sivarconf/2026-/2.0/log.md

# 代码修改日志

## 2026-05-18

### 冷却期结束后重复识别同一张牌 Bug 修复

**问题**：`StabilityStateMachine` 的 COOLDOWN 分支中，冷却期结束后会清空 `confirmed_cards` 和 `confirmed_ranks`，导致同一张牌在冷却期结束后可以被再次确认。

**修复**：冷却期结束后只重置追踪状态（`vote_window`、`vote_counts`等），**保留** `confirmed_cards` 和 `confirmed_ranks`，使排除记录在整次运行中永久生效。

### 滑动窗口投票机制实现

**修改内容**：`StabilityStateMachine` 从连续帧确认改为滑动窗口投票：

1. **参数变更**：`CONSECUTIVE_THRESH=3` → `WINDOW_SIZE=5` + `VOTE_THRESH=3`
2. **数据结构**：用 `vote_window` 列表（最近5帧的 Top1 idx）+ `vote_counts` 字典（各牌出现次数）替代 `current_candidate_consec`
3. **投票逻辑**：每帧先将过滤后的 Top1 入队，窗口满时弹出旧帧；检查是否有牌出现次数达到3次即确认
4. **OSD 显示**：适配新数据结构，显示投票进度条和窗口内容、置信度总和

**修改文件**：`K230/main.py`

### 投票平票时以置信度优先

**修改内容**：`StabilityStateMachine` 新增 `vote_scores` 字典记录窗口内各牌的置信度总和。

**平票裁决逻辑**：
- 多张牌同时达到3票时，首先选**票数最多**的牌
- 若票数相同，则选**置信度总和最高**的牌
- 优先确保识别结果更可靠

**修改文件**：`K230/main.py`

---

## 2026-05-17

### v2.0 最终版发布

- 基于 1.3 封装为最终版 2.0
- 代码已解决所有已知问题，完工

---

## 2026-05-17

### 版本号统一升至 2.0 + 说明书全面同步

**版本变更：**
- 所有 STM32 .c/.h 文件：1.1 → 2.0
- K230/main.py：1.3 → 2.0
- 竞赛小车工程总说明书：v2.2 → v2.0

**说明书最终同步（v2.0 正式版）：**
1. §1.2 B-5 按键描述修正
2. §3.3 bsp_oled/user_main 功能描述更新（无调参页）
3. §4.7 OLED 页面系统：删除 PARAM_B/PARAM_F
4. §5.1 状态图：K2→K3
5. §5.4 按键表/参数表重写（稳定/竞赛模式）
6. §5.2.6 声光提示 K2→K3
7. §7.1/§7.2 流程图 K1 功能更新
8. §8 调参指南重写（编译期固定参数 + 四组参数表）
9. 附录B 版本记录全部更新

### OLED 第一行格式修正

**问题**：`"ti: B%-8s%u%u..."` 格式串产出 21 字符，128px 宽度（16 字符）装不下。

**修复**（`stm32/Core/Src/bsp_oled.c`）：
- 改为 `"ti:%c(%c) %u%u%u%u%u%u%u%u"` 精确 16 字符
- C=竞赛模式，S=稳定模式
- 格式：`ti:B(C) 00000000` 或 `ti:F(S) 00000000`

### 说明书 §6.3 同步至 v16（架构审查 → 文档修复）

**问题**：K230 算法已回退至 v16，但说明书 §6.3 仍描述 v34 完整设计（候选池加权积累、花色总和裁决、7张难检牌等），与代码严重脱节。

**修复**（`竞赛小车工程总说明书.md`）：
1. §1.2 F-1 完成度：算法v34 → 算法v16，保留JOKER优化
2. §3.1 目录树 main.py 描述：v34 → v16
3. §3.3 文件功能一览 main.py 行数/版本：~994/算法v34 → ~684/算法v16
4. §6.3 **整节重写**：从 v34 完整设计替换为 v16 连续帧确认，包含：
   - 回退说明 + 实际参数表（MIN_CONF=0.45, BLANK_GAP=0.30, WARMUP=10, CONSEC=3, COOLDOWN=20）
   - 四关过滤 + 连续帧确认 + S_A↔JOKER交换 + JOKER_B Boost + 单轮排除机制
   - 与 v34 差异对比（移除/保留清单 + 回退理由）
5. 附录B：K230/main.py 版本更新为 1.3（v16回退版，2026-05-17）

### 说明书 K2/K3 按键功能写反修正

**问题**：说明书 §5.4/§7.1/§7.2 中 K2=启动、K3=切题，但代码实际是 K2=切题、K3=启动（2026-05-15 已互换，log有记录）。

**修复**（`竞赛小车工程总说明书.md`）：
1. §5.4 按键处理逻辑表：K2/K3 行互换
2. §5.4 F题启动时序：K2→K3
3. §7.1 B题流程图：K3切题→K2切题，K2启动→K3启动
4. §7.2 F题流程图：同上

### 说明书 §5.4/§8 调参页残留清理

**问题**：代码已删除调参页，新增 K1 切换稳定/竞赛模式，但说明书 §5.4 按键表/§5.1 状态图/§8 调参指南仍描述旧的 OLED 调参行为。

**修复**（`竞赛小车工程总说明书.md`）：
1. §5.1 状态机图：K2→K3
2. §5.4 按键表：重写为 K1 切换模式 / K2 切题 / K3 启动 / K4 停车
3. §5.4 PID参数表：新增 B-S/B-C/F-S/F-C 四组参数
4. §8 调参指南：重写为编译期固定参数 + 四组参数表 + 修改指引

### CARD_COVER_THRESH 死代码修复

**需求**：删除小车的调参设置，添加稳定模式，用按键切换稳定模式/竞赛模式。

**修改内容**：

1. **`stm32/Core/Inc/bsp_oled.h`** — 清理页面枚举，删除 `OLED_PAGE_PARAM_B`、`OLED_PAGE_PARAM_F`、`OLED_PAGE_STABLE_MODE`，只保留 `OLED_PAGE_STANDBY`

2. **`stm32/Core/Src/bsp_oled.c`** — 删除 `Page_Param()` 函数，删除 `OLED_PAGE_PARAM_B/F` 的 switch case，`Page_Standby()` 第一行改为动态显示模式：`ti: B(S)` / `ti: B(C)` / `ti: F(S)` / `ti: F(C)` + 8位灰度值

3. **`stm32/Core/Src/app_line.c`** — 新增两套稳定模式参数：
   - B题稳定模式：base=1000, KP=8.5, KI=0.5, KD=4.5
   - F题稳定模式：base=630, KP=5.7, KI=0, KD=4
   - 新增 `s_stable_mode` 标志、`App_Line_IsStableMode()`、`App_Line_ToggleStableMode()`
   - `App_Line_Init()` 和 `App_Line_Task()` 根据稳定模式选择对应参数组

4. **`stm32/Core/Inc/app_line.h`** — 新增 `App_Line_IsStableMode()`、`App_Line_ToggleStableMode()` 函数声明

5. **`stm32/Core/Src/user_main.c`** — 删除全部调参逻辑（K1进调参页/K2选参数/K3+1/K4-1），K1改为待机页/完成页/错误页切换稳定/竞赛模式

**按键行为（修改后）**：
| 按键 | 待机/完成/错误页 | 运行时 |
|---|---|---|
| K1 | 切换稳定模式(S)/竞赛模式(C) | 无效 |
| K2 | 切换题目B/F | 无效 |
| K3 | 启动运行 | 无效 |
| K4 | 无效 | 手动停车 |

**OLED第一行格式**：`ti: B(S) 11111111`（7字符 + 空格 + 8位灰度 = 16字符）

---

## 2026-05-17

### 说明书 §6.3 同步至 v16（架构审查 → 文档修复）

**问题**：K230 算法已回退至 v16，但说明书 §6.3 仍描述 v34 完整设计（候选池加权积累、花色总和裁决、7张难检牌等），与代码严重脱节。

**修复**（`竞赛小车工程总说明书.md`）：
1. §1.2 F-1 完成度：算法v34 → 算法v16，保留JOKER优化
2. §3.1 目录树 main.py 描述：v34 → v16
3. §3.3 文件功能一览 main.py 行数/版本：~994/算法v34 → ~684/算法v16
4. §6.3 **整节重写**：从 v34 完整设计替换为 v16 连续帧确认，包含：
   - 回退说明 + 实际参数表（MIN_CONF=0.45, BLANK_GAP=0.30, WARMUP=10, CONSEC=3, COOLDOWN=20）
   - 四关过滤 + 连续帧确认 + S_A↔JOKER交换 + JOKER_B Boost + 单轮排除机制
   - 与 v34 差异对比（移除/保留清单 + 回退理由）
5. 附录B：K230/main.py 版本更新为 1.3（v16回退版，2026-05-17）

### 说明书 K2/K3 按键功能写反修正

**问题**：说明书 §5.4/§7.1/§7.2 中 K2=启动、K3=切题，但代码实际是 K2=切题、K3=启动（2026-05-15 已互换，log有记录）。

**修复**（`竞赛小车工程总说明书.md`）：
1. §5.4 按键处理逻辑表：K2/K3 行互换
2. §5.4 F题启动时序：K2→K3
3. §7.1 B题流程图：K3切题→K2切题，K2启动→K3启动
4. §7.2 F题流程图：同上

### CARD_COVER_THRESH 死代码修复

**问题**：`app_line.c` 第 154 行 `CARD_COVER_THRESH = LOST_THRESH_SHORT`（均为 30），导致判断链第二个 `else if (s_lost_cnt < CARD_COVER_THRESH)` 永远无法进入，扑克牌遮线专用逻辑（150ms~300ms 圆弧保持）是死代码。小车在 150ms 后直接进入中等丢线降速模式，而非圆弧保持，在圆形赛道上造成偏轨。

**修复**：
1. `stm32/Core/Src/app_line.c` — `CARD_COVER_THRESH` 从 30 改为 60（300ms）
2. `竞赛小车工程总说明书.md` §5.2.4 丢线保护策略表格更新：明确 150ms~300ms 为圆弧保持，300ms~500ms 为中等丢线降速

**修复后判断链**：
- `< 30` (150ms) → SHORT，保持上一 error 直行
- `< 60` (300ms) → CARD_COVER，保持遮线前角度沿圆弧行进（生效！）
- `< 100` (500ms) → MED，降速找线
- `> 600ms` → ERROR 停车

**修改文件**：`stm32/Core/Src/app_line.c`、`竞赛小车工程总说明书.md`

---

## 2026-05-17

### K230 算法回退至1.0版（v16），保留小王优化

**问题**：1.3版本的v34复杂算法（候选池加权积累、7张难检牌专项优化、花色总和分析等）成功率反而不如1.0版本（v16滑动窗口）。

**决策**：将识别算法回退到1.0版本的v16框架，同时保留从v28/v29/v30移植的小王相关优化。

**回退内容**：
1. **状态机**：v34的候选池加权积累 → **v16滑动窗口连续帧确认**（5帧窗口/3帧确认）
2. **参数**：移除花色总和分析、7张难检牌专项优化、TOP2/3权重投票
3. **参数值**：MIN_CONFIDENCE 0.18→0.45，BLANK_GAP 0.10→0.30，WARMUP 5→30，COOLDOWN 15→20

**保留内容**：
1. **S_A ↔ JOKER 混淆修正**（v28）：Top1=S_A 且分差<0.25时交换两者softmax分值
2. **JOKER_B Boost 机制**（v29/v30）：JOKER_B分值≥0.10时×1.3放大，但Boost后与Top1差距<0.25才生效
3. **UI中文分色显示**（来自1.2版）：黑桃/梅花黑色，红桃/方块红色

**修改文件**：`K230/main.py`

---

## 2026-05-17

### B题第二圈停车后声光无法自动停止

**问题**：B题跑完第二圈后，蜂鸣器和 LED 持续响/亮，无法自动关闭。

**根因**：`s_alert_off_done` 标志在第一圈声光提示 1 秒后被置 1，但 `App_Line_Init()` 在再次运行时未重置该标志。`App_Line_CheckAlertOff()` 的条件是 `s_alert_done && !s_alert_off_done`，由于 `s_alert_off_done` 已是 1，条件恒为假，导致第二圈停车时重新打开的蜂鸣器和 LED 永远无法被关闭。

**修复**：
1. `app_line.c` - 第二圈/一圈完成触发声光时，主动重置 `s_alert_off_done = 0`（双重保障）
2. `user_main.c` - K4 手动停车时，立即关闭蜂鸣器和 LED

**修改文件**：`stm32/Core/Src/app_line.c`、`stm32/Core/Src/user_main.c`

---

## 2026-05-17

### 从 1.2 创建 1.3 存档

- 从 1.2 完整复制所有源码和配置文件
- 清理缓存：.pio、MDK-ARM/build

---

## 2026-05-17

### 说明书 v2.2 修正（§7.1/§7.2 流程图与代码对齐）

**修改文件**：`竞赛小车工程总说明书.md`

**修正内容：**

1. **文件头版本号**：v2.1 → v2.2，更新日期 2026-05-15 → 2026-05-17
2. **§5.2.4 丢线保护表格**：`150ms~150ms` 注释错误 → `150ms~500ms`（两行描述互换）
3. **§7.1 B题流程图**：补充说明 K230全程不参与；明确第一圈声光1秒后自动关闭；第二圈无声光直接停车
4. **§7.2 F题流程图**：明确仅跑一圈；K230在第一圈完成后收到STOP并锁定识别结果；停车时蜂鸣器短响80ms
5. **§7.1/§7.2 关键行为说明**：新增「关键行为说明」小节，解释两题的核心区别
6. **附录B代码版本记录**：STM32版本更新为1.2（BUG修复版）；说明书版本更新为v2.2
7. **文档维护说明**：补充「修改后同步更新」四条规范

---

## 2026-05-15（下午）

### 两题停车时均增加声光提示

**修改文件**：`app_line.c`、`app_line.h`、`user_main.c`

**需求**：B题和F题在最终停车时都应发出声光提示（蜂鸣器+LED）。

**修改内容**：

1. **`app_line.c`** — 停车时统一触发声光：
   - B题第二圈停车时：蜂鸣器响 + LED亮，1秒后自动关闭
   - F题一圈停车时：蜂鸣器响 + LED亮，1秒后自动关闭（与B题停车行为一致）
   - B题第一圈声光提示逻辑保持不变

2. **`app_line.c`** — 新增 `App_Line_CheckAlertOff()` 函数：
   - 检查声光提示是否已达到1秒
   - 达到后自动关闭蜂鸣器和LED
   - 避免在 `App_Line_Task()` 之外（状态已切换为FINISHED）无法执行关闭逻辑

3. **`app_line.h`** — 新增 `App_Line_CheckAlertOff()` 声明

4. **`user_main.c`** — 主循环中调用 `App_Line_CheckAlertOff()`：
   - 每次主循环检查声光是否需要关闭
   - 适用于B题第一圈提示、B题第二圈停车、F题停车三种场景

**最终声光触发时机**：
|| 题目 | 触发时机 | 蜂鸣器 | LED |
||---|---|---|-----|
|| B题 | 第一圈完成 | 响1秒 | 亮1秒 |
|| B题 | 第二圈（最终）停车 | 响1秒 | 亮1秒 |
|| F题 | 一圈（最终）停车 | 响1秒 | 亮1秒 |

### 代码审查修复（2026-05-15 晚）

**修复内容：**

1. **app_line.c** — 修正注释：描述改为与 PDF 题目一致（基础题=走两圈+声光，发挥题=一圈+K230识别），修复"150ms~150ms"注释错误
2. **user_config.h** — 新增 `WHEEL_DIAMETER_CM = 100` 常量，供 OLED 距离计算使用
3. **bsp_oled.c** — 待机页距离计算公式改为 `enc_total / ONE_LAP_COUNT * pi * WHEEL_DIAMETER_CM`
4. **K230/main.py** — JOKER_B Boost 条件修正：检查 Boost 后差距而非 Boost 前
5. **bsp_uart_k230.h** — 协议注释修正：移除旧 `$START`/`$STOP` 字符串协议，改为单字节 `0x01`/`0x02`
6. **app_control.c** — 删除无用的 `(void)` 强转语句
7. **bsp_gray.c** — 版本号更新为 1.1 / 2026-05-15

### 代码审查 - 发现多个严重 Bug

**审查范围**：STM32 全部源码 + K230/main.py + 所有头文件 + 竞赛说明书

**发现严重 Bug（需立即修复）：**

#### 🔴 Bug 1：B题/F题逻辑完全写反了

**文件**：`stm32/Core/Src/app_line.c` 第 305-324 行

**问题**：注释写 "F题" 但代码是 `QUESTION_B`，注释写 "B题" 但代码是 `QUESTION_F`
- `QUESTION_B` 时声光提示（应为 F 题行为）
- `QUESTION_F` 时发 STOP（应为 F 题行为，但 F 题应该停车）

**实际后果**：
| 题目 | 预期 | 实际 |
|---|---|---|
| B题 | 一圈声光→再跑一圈→停车 | 直接停车（没有声光） |
| F题 | 一圈停车+K230停止识别 | 声光提示（无停止识别） |

**修复**：将第 305 行和第 313 行中的 `QUESTION_B` ↔ `QUESTION_F` 互换

#### 🔴 Bug 2：F题串口START发送逻辑位置错误

**文件**：`stm32/Core/Src/user_main.c` 第 117-120 行

**问题**：K3 按下启动时发送 `$START`，但根据 log.md 最新记录（待机页 K2=启动，K3=切换题目），F题按 K2 启动时不会发送 `$START`

**修复**：将 `BSP_UART_K230_SendStart()` 移到 K2 的启动分支中

#### 🔴 Bug 3：OLED待机页距离计算公式错误

**文件**：`stm32/Core/Src/bsp_oled.c` 第 115 行

**问题**：直接用 `314.0f`（π×100）计算，未考虑 enc_total 是累计值
- 正确：`dist = enc_total / ONE_LAP_COUNT * π * D`
- 当前：`dist = enc_total / ONE_LAP_COUNT * 314`（两圈时显示翻倍）

**修复**：改为 `enc_total / ONE_LAP_COUNT * 3.14159f * WHEEL_DIAMETER_CM`

#### 🔴 Bug 4：编码器达到上限后继续累加

**文件**：`stm32/Core/Src/app_line.c` 第 298-302 行

**问题**：ENC_TOTAL_MAX 截断后下一帧仍继续累加 delta，导致编码器值在上限附近持续波动

**修复**：达到上限后不再累加，或设置标志位

#### 🔴 Bug 5：K230 JOKER_B Boost 条件注释与代码逻辑不符

**文件**：`K230/main.py` 第 636-638 行

**问题**：注释说"差距过大时跳过"，但检查的是 boost 前的差距。应改为检查 boost 后的差距

**修复**：改为 `if boosted_jb > 0 and top1_val - boosted_jb < JOKER_B_MAX_GAP:`

#### 🟡 Bug 6：bsp_uart_k230.h 注释协议与代码不符

**问题**：头文件注释写的是 `$START\n`/`$STOP\n`，实际代码发送的是 `0x01`/`0x02` 单字节

#### 🟡 Bug 7：app_control.c 无用的 (void) 强转

**文件**：`app32/Core/Src/app_control.c` 第 40-43 行

**问题**：`App_Control_SetLineParams()` 函数有一串无意义的 `(void)` 语句

#### 🟡 Bug 8：bsp_gray.c 版本号未更新

**文件**：`stm32/Core/Src/bsp_gray.c` 第 12 行

**问题**：版本 1.0，日期 2026-05-13，其他文件都已更新到 1.1 / 2026-05-15

#### 🟡 Bug 9：app_line.c 注释数字写错

**文件**：`stm32/Core/Src/app_line.c` 第 264 行

**问题**：注释写"150ms~150ms"，应为"150ms~500ms"

---

### 待机页按键2/3功能互换

**修改文件**：`stm32/Core/Src/user_main.c`

**互换内容**：
- K2：待机页由"启动"改为"切换题目（B/F）"
- K3：待机页由"切换题目"改为"启动"

**调整理由**：操作习惯更顺手。

---

### 竞赛小车工程总说明书 v2.1 — 题目细节补充 + 串口功能明确

**更新内容：**

1. **第1章增加详细题目描述**：赛道形状、扑克牌放置方式（背面朝上/正面朝上）、检测方式
2. **第1章增加关键设计考量**：圆形赛道、摄像头识别难点
3. **发挥部分完成度更新**：移除「识别结果回传OLED」，改为「K230 LCD中文显示」（已实现）
4. **第6章串口协议明确**：STM32 ↔ K230 串口仅负责 START/STOP 控制，不承载识别结果数据
5. **待完成功能精简**：移除K230结果回传相关条目，保留ONE_LAP_COUNT实测标定（高优先级）

**待完成功能（精简后）：**
- 高优先级：ONE_LAP_COUNT 实测标定
- 中优先级：K230与STM32联调、B题第二圈、F题LCD界面优化

### K230 扑克牌识别算法 v1.1 — 最终稳定版

**本次整理**：删除 v8-v34 详细迭代记录，保留最终版本核心说明。

**最终参数配置**：

| 参数 | 值 | 说明 |
|---|-----|---|
| MIN_CONFIDENCE | 0.18 | 最低置信度门槛 |
| BLANK_GAP | 0.10 | Top1 与 BLANK 的最小差距 |
| TOP_GAP_THRESH | 0.08 | Top1 与 Top2 最小差距 |
| TOP1_NOISE_THRESH | 0.50 | Top1 弱识别阈值 |
| VOTE_THRESH | 3 | 确认所需票数 |
| MIN_VOTE_FRAMES | 2 | 确认所需最少帧数 |
| COOLDOWN_FRAMES | 10 | 确认后冷却帧数 |
| JOKER_GAP_THRESH | 0.25 | S_A 与 JOKER 交换阈值 |
| TOP23_MIN_CONF | 0.18 | Top2/3 最低置信度 |
| WARMUP_FRAMES | 5 | 开机预热帧数 |

**最终参数配置（续）**：

| 参数 | 值 | 说明 |
|---|-----|---|
| TOP2_WEIGHT | 0.5 | Top2 投票权重 |
| TOP3_WEIGHT | 0.3 | Top3 投票权重 |
| JOKER_B_DETECT_MIN | 0.10 | JOKER_B Boost 最低分值 |
| JOKER_B_BOOST_MULT | 1.3 | JOKER_B Boost 系数 |
| JOKER_B_MAX_GAP | 0.25 | JOKER_B Boost 最大差距 |

**算法核心特性**：

1. **S_A ↔ JOKER 混淆修正**（v28/v33）：
   - 当 Top1=S_A 且 S_A 与 JOKER 分差 < 0.25 时交换两者 softmax 值
   - 解决小王/大王被误识别为黑桃A 的问题

2. **JOKER_B Boost 机制**（v29/v30）：
   - JOKER_B 分值 >= 0.10 时乘以 1.3 放大
   - Boost 后与 Top1 差距 >= 0.25 时跳过 Boost（防止误触发）

3. **花色总和分析**（v33）：
   - 移除花色补偿，改为计算每种花色的 softmax 置信度总和
   - 同颜色不同花色冲突时（H vs D，S vs C），用花色总和对进行裁决

4. **7张难检牌专项优化**（v27/v31）：
   - C_10、C_6、C_8、C_9、C_K、D_Q、JOKER_B
   - Top1 保护机制：困难牌 Top1 时允许 Top2 更接近
   - 难检牌确认门槛更低（vote_score >= 0.25）

5. **候选池加权积累**（v25/v26/v27）：
   - 冷却期内 Top1 → +1.0 票，Top2 → +0.5 票，Top3 → +0.3 票
   - 每帧检查候选池，达到阈值立即确认

6. **同 rank 过滤**：
   - confirmed_cards 永久排除（整次运行）
   - cooldown_ranks 临时排除（仅冷却期内）

7. **TRACKING 分支降级投票**：
   - Top1 被确认/冷却时自动降级到 Top2/3

**算法版本演进简史**：

| 版本 | 核心改进 |
|---|---|
| v8 | 稳定性确认 + 冷却期状态机 |
| v13 | confirmed_ranks 集合防一牌多结果 |
| v16 | 永久排除 confirmed_cards |
| v20 | 修复冷却期 rank 检查 bug |
| v23 | 每张牌独立 vote_count |
| v25 | COOLDOWN 每帧检查候选池 |
| v27 | 7张难检牌专项优化 |
| v28 | S_A ↔ JOKER 混淆修正 |
| v29 | JOKER_B Boost 机制 |
| v31 | D_Q boost + Top1 保护 |
| v33 | 花色总和分析替代花色补偿 |
| v34 | 参数微调（漏牌问题优化） |

### K230 代码整理 v1.3 — UI 中文分色 + FPS 恢复

**UI 增强**：
1. **FPS 恢复**：左上角显示 FPS
2. **中文 + 红黑分色**：`label_to_display()` 函数将标签转为中文显示
   - 黑桃/梅花：黑色 (0,0,0)
   - 红桃/方块：红色 (255,0,0)
   - 小王：黑色，大王：红色
3. **结果展示**：46号字体，超过8张时分两列（第9张起从右边开始排）
4. **识别中已确认列表**：28号字体，按红黑色显示

**修改文件**：`K230/main.py`

## 2026-05-15（下午）

### 代码整理 v1.1 — 删除冗余注释 + 统一版本号

**问题**：多个源码文件存在大量重复的文件头注释（同一个文件有 2-3 个重复的 `@file` 块），版本号均为 1.0，需要清理。

**`stm32/Core/Src/app_line.c`**：
- 去除重复文件头注释
- 版本更新为 1.1，日期更新为 2026-05-15
- 注释描述精简，保留核心功能说明

**`stm32/Core/Src/bsp_oled.c`**：
- 版本更新为 1.1，日期更新为 2026-05-15
- 注释描述修正

**`stm32/Core/Src/app_control.c`**：
- 版本更新为 1.1，日期更新为 2026-05-15

**`stm32/Core/Src/bsp_uart_k230.c`**：
- 去除重复文件头注释（原有 3 个重复块）
- 版本更新为 1.1，日期更新为 2026-05-15

**`stm32/Core/Src/app_state.c`**：
- 去除重复文件头注释（原有 3 个重复块）
- 版本更新为 1.1，日期更新为 2026-05-15

**`stm32/Core/Src/bsp_motor.c`**：
- 去除重复文件头注释（原有 2 个重复块）
- 版本更新为 1.1，日期更新为 2026-05-15

**`stm32/Core/Src/bsp_encoder.c`**：
- 去除重复文件头注释（原有 2 个重复块）
- 版本更新为 1.1，日期更新为 2026-05-15

**`stm32/Core/Src/bsp_beep.c`**：
- 去除重复文件头注释（原有 2 个重复块）
- 版本更新为 1.1，日期更新为 2026-05-15

**`stm32/Core/Src/bsp_led.c`**：
- 去除重复文件头注释（原有 3 个重复块）
- 版本更新为 1.1，日期更新为 2026-05-15

**`stm32/Core/Src/bsp_gray.c`**：
- 去除重复文件头注释
- 版本更新为 1.1，日期更新为 2026-05-15

**`stm32/Core/Src/bsp_delay.c`**：
- 去除重复文件头注释（原有 2 个重复块）
- 版本更新为 1.1，日期更新为 2026-05-15

**`stm32/Core/Src/bsp_key.c`**：
- 去除重复文件头注释（原有 2 个重复块）
- 版本更新为 1.1，日期更新为 2026-05-15

**`K230/main.py`**：
- 去除内部版本标注混乱
- 版本更新为 1.1，日期更新为 2026-05-15
- 文件头注释精简，保留核心功能说明

## 2026-05-15（凌晨）

### K230 识别算法 v34 — 微调参数减少漏牌

**问题回顾（v33 测试反馈）**：
- 基本差不多了，有部分漏牌和错误
- 换个角度或位置基本都能测准
- 花色裁决 Top1/2 分差调到 0.2 效果很不错

**v34 参数微调（基于用户反馈）**：

| 参数 | v33 | v34 | 说明 |
|---|-----|-----|---|
| 花色裁决 gap | 0.10 | **0.20** | 效果很好，用户确认 |
| MIN_CONFIDENCE | 0.20 | **0.18** | 接收更多弱识别帧 |
| BLANK_GAP | 0.12 | **0.10** | 更多弱帧能通过 |
| TOP23_MIN_CONF | 0.20 | **0.18** | 与 MIN_CONFIDENCE 同步 |
| 普通牌确认门槛 | >=0.30, gap>=0.20 | **>=0.28, gap>=0.15** | 更易确认减少漏牌 |

### K230 识别算法 v33 — 彻底移除花色补偿，改为花色总和裁决

**问题回顾（v32 测试反馈）**：
- 数量准确，颜色准确
- 同颜色不同花色分不清（如红桃 vs 方块、黑桃 vs 梅花）
- 花色补偿会影响原本就正常的识别
- 小王又变成黑桃A

**v33 核心重构**：
1. **完全移除花色补偿**：删除 `_compute_suit_boosted_scores()`
2. **新增花色总和分析**：`_compute_suit_sums()` 计算每种花色的 softmax 总置信度和
3. **新增花色裁决**：`_resolve_suit_conflict()` 当 Top1/2 分差 < 0.20 且同颜色不同花色时，比较两花色的总置信度和
4. **JOKER_GAP_THRESH: 0.15→0.25**：更容易把 S_A 换下去

### K230 识别算法 v31 — 针对性优化7张难检牌

**问题回顾（v30 日志分析）**：
- 测试牌组：梅花10、梅花6、梅花8、方块Q、梅花9、小王、梅花K
- 确认：C_10、S_A、C_8、C_7、S_J、C_K、S_Q、JOKER_B、S_9（9张）
- **误确认：S_6（真牌是梅花6）** — Top1 始终是 S_6，C_6 从未出现
- **误确认：S_J（真牌是方块Q）** — Top1 始终是 H_J/D_Q，S_J 确认
- **丢失：D_Q（方块Q）** — D_Q 出现在 Top2/3，但从未达到 Top1
- **丢失：C_6（梅花6）** — 被 S_6 压制，从未出现

**v31 根因分析**：
1. **D_Q 丢失**：方块Q 置信度系统性偏低，SUIT_BOOST_SUITS 只有 C 和 JOKER_B，没有 D
2. **C_6 被 S_6 压制**：困难牌 Top1 与 Top2 分差极小时被降权，S_6=0.387, C_6=0.312 → gap 仅 0.075，vote_score 降权后 < MIN_CONF=0.20，无法投票
3. **S_J 被误确认**：D_Q=0.232, H_J=0.233，D_Q 应该是 Top1 但 H_J 以微弱优势获胜
4. **S_A 冷却期内误加入候选池**：S_A 确认后，冷却期内 Top1=S_A 时被加入候选池，干扰下一张牌确认

**v31 核心修复**：
1. **D_Q boost**：将 D 加入 SUIT_BOOST_SUITS `{"C", "D", "JOKER_B"}`
2. **JOKER_GAP_THRESH 降低**：0.20 → 0.15，更敏感识别 S_A↔JOKER 混淆
3. **困难牌 Top1 保护**：困难牌 Top1 时允许 Top2 不超过 Top1×1.2
4. **S_A 冷却期保护**：冷却期内 Top1 是 S_A 时不加入候选池

### K230 识别算法 v30 — JOKER_B Boost 防误触发机制

**v30 核心修复：Boost 防误触发机制**：
- `JOKER_B_MAX_GAP = 0.25`：Boost 后 JOKER_B 与 Top1 差距必须 < 0.25 才生效
- Boost 系数从 1.5 降至 1.3（温和放大，减少把普通牌误推上 Top1 的风险）

### K230 识别算法 v29 — JOKER_B Boost 机制

**v29 根因分析**：
- JOKER_B 自身 softmax 分值过低（<0.10），即使出现在帧中也过不了识别阈值
- v28 的 S_A 交换逻辑只解决"S_A 误识别为 JOKER"的问题

**v29 核心修复：JOKER_B Boost 机制**：
- JOKER_B softmax 分值 >= 0.10 时，直接乘以 1.5 倍放大
- Boost 在 S_A 交换之后执行，确保 JOKER_B 能从交换中获益

### K230 识别算法 v28 — S_A↔JOKER混淆修正 + 花色补偿优化

**v28 根因分析（小王误识别为S_A）**：
- 模型对 JOKER_B 存在系统性误识别：softmax 中 S_A 得分较高，JOKER_B 得分紧随其后
- 典型场景：S_A=0.55, JOKER_B=0.42，分差仅 0.13

**v28 核心修复：S_A ↔ JOKER_* 混淆修正**：
- 当 Top1=S_A 且 S_A-JOKER_* 分差 < JOKER_GAP_THRESH=0.20 时，交换两者 softmax 分值

### K230 识别算法 v27 — 7张难检牌专项优化

**v27 根因分析**：
- 7张难检牌中，**5张是梅花花色**，模型对梅花存在系统性置信度偏低
- Top1 与 Top2/3 的分差极小（gap < 0.08），TOP1_NOISE 大量触发
- 极低置信度帧（0.20~0.30）被硬性丢弃

**v27 三大核心优化**：
1. **花色级置信度补偿**：对梅花/小王，将同花色所有牌的 softmax 分值累加到目标牌
2. **候选池加权计数**：Top1→+1.0票，Top2→+0.5票，Top3→+0.3票
3. **TRACKING 分支动态阈值**：难检牌 vote_score >= 0.20 即投票

### K230 识别算法 v26 — 修复"一张牌检测到多张"问题

**v25 Bug 根因分析**：
- COOLDOWN 分支只过滤 `idx ∈ confirmed_cards`，不检查 rank
- 冷却期内同一物理牌的不同花色全部进入候选池 → 某花色达到2票 → 被误确认为新牌

**v26 核心修复**：
1. COOLDOWN 分支增加 rank ∈ cooldown_ranks 过滤
2. TRACKING 分支增加 rank ∈ cooldown_ranks 过滤 + 降级投票

### K230 识别算法 v25 — 难检牌专项优化

**v25 根因分析与核心修复**：
1. TRACKING 分支 Top1 被过滤时直接丢弃 → 改为降级投票
2. COOLDOWN 分支候选池积累不足 → 确保每帧至少一个候选
3. COOLDOWN 每帧检查候选池：达到阈值立即确认

### K230 识别算法 v23 — 每张牌独立 vote_count

**v23 Bug 详解**：
- 共享 vote_window 导致不同花色互抢
- D_5 和 H_3 各 1 票互不相让，H_3 永远无法确认

**v23 核心修复**：
- 每张牌有独立的 `vote_counts[idx]` 计数器
- 每帧只有 Top1 计入对应牌的计数器

### K230 识别算法 v22 — 候选池机制

**v22 Bug 详解**：
- 冷却期内 cls_idx=-1 的帧不加入 vote_window，导致冷却期结束后窗口为空

**v22 核心修复：引入候选池机制**：
- 冷却期内所有有效帧加入 candidate_pool
- 冷却期结束分析候选池，达到阈值则立即确认

## 2026-05-15（凌晨）

### K230 识别算法 v20 — 修复 COOLDOWN 分支 elif 缺少 rank 检查

**v19 致命 bug 详解**：
- COOLDOWN 分支 elif 只检查 `cls_idx in confirmed_cards`，没检查 `rank in cooldown_ranks`
- 导致 H_4 冷却期内 H_5 被误加入窗口，H_5 被误确认为假牌

**v20 核心修复**：
- COOLDOWN 分支 elif 增加 rank 检查
- 冷却期内 Top1 是已确认牌时，只有当 rank 不在 cooldown_ranks 中才替换

### K230 识别算法 v19 — 修复确认后窗口未清空

**v18 Bug**：
- 确认一张牌后 vote_window 未清空，已确认牌继续在窗口中占位

**v19 核心修复**：
- 确认后立即清空 vote_window
- 冷却期内也检查 cooldown_ranks

## 2026-05-14（深夜）

### K230 识别算法 v18 — 修复投票计数Bug（核心Bug导致8张牌0确认）

**v17 Bug**：
- `_add_to_window()` 中有去重逻辑，同一张牌第二次出现时被跳过
- `_get_best_in_window()` 统计的是不同牌的种类数，而不是每张牌的出现次数

**v18 核心修复**：
- 移除去重逻辑，同一张牌可以多次加入窗口
- 预热期缩短：30帧→15帧
- 冷却期缩短：20帧→15帧

### K230 识别算法 v17 — 滑动窗口投票 + 宽松冷却

**v16 丢牌分析**：
- H_3 被检测到但因部分帧置信度 0.45-0.57 低于 0.60 阈值

**v17 核心修复**：
- MIN_CONFIDENCE 从 0.60 → 0.45
- 滑动窗口投票：5帧窗口，3帧同牌确认
- 冷却期只排具体牌，不排同 rank

## 2026-05-14（晚）

### K230 识别日志功能

- 每次运行在 K230 `/data/` 目录写 `recognition_log.txt`
- 记录每帧的 cls_idx、Top-N、置信度、状态机状态、投票信息
- 关键事件（START/STOP/CONFIRMED）突出记录

## 2026-05-13（晚）

### 代码整理 + 注释规范化 + 版本1.0封装

**文件头注释补全**：为所有C源文件添加标准文件头注释（@file、@brief、功能概述、版本、日期）。

**`app_line.h`**：Kp/Ki/Kd 类型从 `float` 改为 `int16_t`（配合参数扩大10倍存储）

**`app_line.c`**：
- PID 参数扩大10倍存储（B_KP=120/B_KD=50/F_KP=60/F_KD=40）
- 去除重复的 PID 参数赋值代码块

**`bsp_oled.c`**：`Page_Param()` 改用整数运算替代 `%f` 浮点格式化

### 圆形赛道循迹优化（误差平滑 + 积分项）

- **F题启用积分项**：`F_KI` 从 0 改为 3（消除稳态误差）
- **B题 BASE_PWM** 从 1250 调整为 1300

### PID 参数扩大10倍存储（支持±0.1微调）

- PID 参数内部扩大10倍存储（int16_t），OLED 显示时除以 10.0
- K3/K4 每次 ±1，对应实际 PID 值变化 ±0.1

## 2026-05-13（下午）

### OLED 上电初始化延时修复

- 新 OLED 屏幕内部有更长的上电稳定时间
- `OLED_Init()` 开头增加 100ms 延时

### K230 识别算法 v16 — 解决"一张牌检测出多张牌"问题

**v15 根因**：冷却期结束后重置 `confirmed_cards` 和 `confirmed_ranks`，导致同一张牌被重新确认

**v16 核心修复**：
- `confirmed_cards` 和 `confirmed_ranks` 在整次运行中永久生效
- 冷却期结束后不清空，只清空 `vote_window`

### K230 识别算法 v15 — 滑动窗口投票

- 7帧滑动窗口，3帧同牌确认
- 允许模型在窗口中跳1-2帧，减少丢牌

### K230 识别算法 v14 — 彻底重写状态机（连续帧确认）

- 连续5帧确认替代窗口统计
- 打断即重置，从根本上堵住积分游戏漏洞

### K230 识别算法 v13 — 修复一牌多结果 + 防无牌误识别增强

- 新增 `confirmed_ranks` 集合，同 rank 所有牌同时过滤
- BLANK_GAP 提高：0.20 → 0.25

### K230 识别算法 v12 — 确认后立即排除已确认牌

- 新增 `confirmed_cards` 集合（永久排除）
- 每帧先过滤已确认牌，Top1 被确认则自动替换为 Top2

### K230 识别算法 v10 — 解决 H_7/D_7 互抢丢牌 + 花色置信度裁决

- 去掉 Top-N 辅助计数，只计最终 Top1
- 新增 `_resolve_frame()` 花色置信度裁决

### K230 识别算法 v9 — 参数优化（针对前两张牌丢牌率高）

- 预热期：50帧→30帧，窗口：20帧→15帧
- 确认阈值：8次→6次，冷却期：20帧→15帧

### K230 识别算法全面重写 v8 — 稳定性确认 + 冷却期状态机

- `StabilityStateMachine` 类替代 `SlidingWindowManager`
- 状态流转：IDLE → CONFIRMING → COOLDOWN
- 冷却期机制彻底解决"一张牌读出多种"问题

## 2026-05-12（下午）

### OLED待机页显示行驶距离和用时

- 待机页第二行：行驶距离（cm）
- 待机页第三行：行驶用时（精确到0.01秒）
- 快照变量记录停车时刻的编码器值

### K230 数据收集脚本更新

- 6种类别（C_7, D_3, D_K, D_Q, JOKER_B, JOKER_R）
- 每种 200 张（1 批次），共 1200 张

### K230 识别器 v6/v7 — BLANK 防误识别 + 开机预热

- BLANK 分差门槛：Top1 必须比 BLANK 高至少 0.15
- 开机预热：前15帧识别结果不入滑动窗口

### K230 LCD 屏幕驱动修复

- 使用 `Display.show_image(img, x=0, y=0, mode=1)` 驱动 LCD 主帧缓冲
- 建议升级到 PreRelease 固件解决黑屏/闪屏问题

## 2026-05-12（上午）

### K230 数据收集脚本重写（扑克牌识别训练数据）

- 54种扑克牌类别（A~K × 4花色 + 大小王）
- 类别命名：`S_A` ~ `S_K`, `H_A` ~ `H_K`, `C_A` ~ `C_K`, `D_A` ~ `D_K`, `JOKER_B`, `JOKER_R`
- 分辨率 640×480，按键控制采集

### K230 LCD 屏幕不显示问题修复

## 2026-05-11（晚）

### F题串口通信 + K230扑克牌识别展示

- STM32 → K230：`$START\n` / `$STOP\n`
- K230 串口协议改为纯字节：0x01(START)/0x02(STOP)
- 白屏展示：白色背景，中文花色名称逐行打印

### 题目逻辑修正 + 代码清理

- B题：一圈后声光提示，再跑完一圈停车（共两圈）
- F题：一圈后直接停车

## 2026-05-11

### OLED页面简化：删除调试页，自动跳转待机页

### 题目枚举重构：B1→B（基础题），B2→F（发挥题）

### K230 main.py 全面迁移至 PipeLine 框架

- 适配 CanMV K230 v1.6
- 通道0显示，通道2 AI推理

## 2026-05-10

### 代码全面检查与修复

- `gpio.c`：修正 PB4/PB5 引脚注释
- `09_1数据收集.py`：修复按键去抖逻辑错误
- `app_line.c`：为 `s_enc_total` 添加上限保护

### B2题声光提示修正 + LED亮灭逻辑修正

- 声光提示1秒后自动关闭
- LED 亮灭逻辑修正

### 基础题B1/B2双题支持及一圈/两圈计数

- 新增 `QuestionType_t` 枚举
- B1：一圈停车，B2：两圈后声光提示再跑完两圈停车

### 巡线一圈自动停车功能

- `ONE_LAP_COUNT` 宏定义一圈目标编码器值
- 达到目标后自动停车 + 切换 FINISHED 状态

### 巡线方向修正（左右PWM分配反了）

- 交换左右轮 PWM 公式

## 2026-05-09

### 第五阶段：开环低速循迹

- 8路灰度权重设计：`-40,-20,-10,-5,+5,+10,+20,+40`
- PD控制：`pwm_out = Kp*error + Kd*(error - last_error)`
- 丢线保护：150ms内保持上一周期，500ms内降速，600ms以上停车

## 2026-05-08

- 检查并整理 STM32 工程结构
- 修正右轮电机接线顺序
- 新增编码器测试功能
- 扩展串口调试命令支持

## 2026-05-09

### 灰度传感器驱动开发

- 纯软件模拟 I2C，PA5=SCL, PA4=SDA
- I2C 地址 0x4E（AD1=1, AD0=0）
- 支持 ping、数字量、模拟量、错误信息、版本号读取

### 最终接线对应

| 总线 | SCL | SDA | 用途 |
|---|---|---|---|
| 灰度传感器（软件模拟 I2C） | PA5 | PA4 | 灰度 8 路传感器 |
| OLED（硬件 I2C1） | PB8 | PB9 | OLED 显示屏 |

### 2026-05-20 | main_new2.py VOTING 窗口判断 bug 修复

**问题**：`VOTING` 状态下窗口结束条件用 `voting_frames_collected >= WINDOW_SIZE`，但该计数器只在低置信度帧（cls_idx < 0 或无 valid candidates）时不递增，导致低置信度帧出现时窗口无限拉长。

**修复**：将窗口结束条件改为 `round_total_frames >= WINDOW_SIZE`（每帧必递增），并修正 `_tick_finalize` 调用以避免 `cls_idx < 0` 时引用未定义变量 `valid`。

### 2026-05-20 | main_new2.py DISCARDING 帧数超时修复

**问题**：`DISCARDING` 状态下 `cls_idx < 0` 或无 valid candidates 时直接 return，`round_total_frames` 未递增，帧配额被浪费，导致无限等待。

**修复**：入口统一递增 `round_total_frames`，设置总超时上限 `DISCARD_FRAMES + WINDOW_SIZE = 9` 帧，超时后强制进入 VOTING（重置投票状态后继续，不丢弃本轮）。

### 2026-05-21 | app_line.c F题参数统一

**修改**：挑战题（F题）不再区分稳定模式和高速模式，统一使用一套参数：PWM=600，KP=6.0，KI=0，KD=4.0。基础题（B题）两种速度及其他参数保持不变。

### 2026-05-21 | main_new2.py v22 回顾一致性检查（S_10 vs C_8 覆写）

**目的**：解决 S_10 和 C_8 容易互相误识别的问题。当投票确认 S_10 后，对本轮投票历史做回顾检查，三条件全满足则覆写为 C_8。

**条件**：
- 条件 A：S_10 当 top1 的比例 < 85%（有其他类抢过 #1）
- 条件 B：C_8 分数 > 0.05 出现在 Top3 中出现过 >= 3 帧（C_8 不是偶然露脸）
- 条件 C：S_10 > 0.7 的高置信帧 < 3 帧（S_10 缺乏持续高分）

**修改点**：
- `StabilityStateMachine.__init__`：增加 `C_8_idx` 属性
- 新增 `_retrospective_s10_vs_c8_check(confirmed_idx, history)` 方法
- `_tick_confirm` / `_tick_finalize`：在确认时调用回顾检查，追加 `should_override` 返回值
- `tick` 方法：所有返回语句增加第 8 元素 `should_override=False`
- `vote_history`：每帧记录增加 `"top3"` 字段用于条件 B 检测
- 主循环：确认后检查 `should_override`，为 true 时将结果覆写为 C_8
- 版本升至 v22 / 2.2
