sivarconf/2026-/3.0/log.md

# 代码修改日志

## 2026-05-21

### 版本升至 3.0 — 全面整理代码 + 清理死代码 + 修正注释

**所有文件版本统一升至 3.0，日期统一为 2026-05-21。**

#### 死代码清理

**`stm32/Core/Src/app_line.c`** — 删除以下未被调用的函数和变量：
- `s_tune_param` 静态变量（运行时调参已废弃）
- `App_Line_GetTuneParam()`
- `App_Line_NextTuneParam()`
- `App_Line_AdjustQuestionTuneParam()` — 替换为空桩（仍有外部声明引用）
- `App_Line_PrintDebug()`
- `App_Line_SetParams()`
- `LINE_BASE_PWM_STEP`、`LINE_PID_STEP` 宏

**`stm32/Core/Src/app_control.c`** — 删除 `App_Control_SetLineParams()` 死函数

**`stm32/Core/Inc/app_control.h`** — 删除 `App_Control_SetLineParams()` 声明

**`stm32/Core/Inc/app_line.h`** — 同步删除未使用函数声明：
- 删除 `LineTuneParam_t` 枚举
- 删除 `App_Line_SetParams()`、`App_Line_GetTuneParam()`、`App_Line_NextTuneParam()`、`App_Line_AdjustQuestionTuneParam()`、`App_Line_PrintDebug()` 声明

#### 注释修正

**`stm32/Core/Inc/app_state.h`** — 修正 `QuestionType_t` 枚举注释：
- `QUESTION_B`: "基础题：循迹一圈后声光提示，再跑完一圈停车"（原来写反了）
- `QUESTION_F`: "发挥题：循迹一圈后停车，K230识别扑克牌"（原来写反了）

**`stm32/Core/Src/app_line.c`** — 修正 F题注释：
- `F_BASE_PWM = 700` 注释 → `F_BASE_PWM = 600`
- F题稳定模式参数修正：base=630, KP=57(KP=5.7)

**`stm32/Core/Src/bsp_oled.c`** — 文件头注释修正：
- 删除"调参B页/调参F页"描述（调参页已删除）

**`stm32/Core/Src/bsp_gray.c`** — 文件头注释全面重写：
- 删除"16路灰度"、"SPI1"等错误描述
- 更新为"8路灰度传感器"、"软件模拟I2C"

#### 版本更新

|| 文件 | 旧版本 | 新版本 |
|---|---|---|---|
| 所有 STM32 .c/.h 文件 | 2.0 | 3.0 |
| `K230/main.py` | 2.2 | 3.0 |

---

## 2026-05-18

### 冷却期结束后重复识别同一张牌 Bug 修复

**问题**：`StabilityStateMachine` 的 COOLDOWN 分支中，冷却期结束后会清空 `confirmed_cards` 和 `confirmed_ranks`，导致同一张牌在冷却期结束后可以被再次确认。

**修复**：冷却期结束后只重置追踪状态（`vote_window`、`vote_counts`等），**保留** `confirmed_cards` 和 `confirmed_ranks`，使排除记录在整次运行中永久生效。

### 滑动窗口投票机制实现

**修改内容**：`StabilityStateMachine` 从连续帧确认改为滑动窗口投票：

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

**修改文件**：`K230/main.py`

### 投票平票时以置信度优先

**修改内容**：`StabilityStateMachine` 新增 `vote_scores` 字典记录窗口内各牌的置信度总和。

**平票裁决逻辑**：
- 多张牌同时达到3票时，首先选**票数最多**的牌
- 若票数相同，则选**置信度总和最高**的牌
- 优先确保识别结果更可靠

**修改文件**：`K230/main.py`

---

## 2026-05-17

### v2.0 最终版发布

- 基于 1.3 封装为最终版 2.0
- 代码已解决所有已知问题，完工

---

## 2026-05-17

### 版本号统一升至 2.0 + 说明书全面同步

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

### OLED 第一行格式修正

**问题**：`"ti: B%-8s%u%u..."` 格式串产出 21 字符，128px 宽度（16 字符）装不下。

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

### 说明书 §6.3 同步至 v16（架构审查 → 文档修复）

**问题**：K230 算法已回退至 v16，但说明书 §6.3 仍描述 v34 完整设计（候选池加权积累、花色总和裁决、7张难检牌等），与代码严重脱节。

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

### 说明书 K2/K3 按键功能写反修正

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

### 说明书 §5.4/§8 调参页残留清理

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

### CARD_COVER_THRESH 死代码修复

**需求**：删除小车的调参设置，添加稳定模式，用按键切换稳定模式/竞赛模式。

**修改内容**：

1. **`stm32/Core/Inc/bsp_oled.h`** — 清理页面枚举，删除 `OLED_PAGE_PARAM_B`、`OLED_PAGE_PARAM_F`、`OLED_PAGE_STABLE_MODE`，只保留 `OLED_PAGE_STANDBY`

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

4. **`stm32/Core/Inc/app_line.h`** — 新增 `App_Line_IsStableMode()`、`App_Line_ToggleStableMode()` 函数声明

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

**OLED第一行格式**：`ti: B(S) 11111111`（7字符 + 空格 + 8位灰度 = 16字符）

---

## 2026-05-17

### 说明书 §6.3 同步至 v16（架构审查 → 文档修复）

**问题**：K230 算法已回退至 v16，但说明书 §6.3 仍描述 v34 完整设计（候选池加权积累、花色总和裁决、7张难检牌等），与代码严重脱节。

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

### 说明书 K2/K3 按键功能写反修正

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

### CARD_COVER_THRESH 死代码修复

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

**修改文件**：`stm32/Core/Src/app_line.c`、`竞赛小车工程总说明书.md`

---

## 2026-05-17

### K230 算法回退至1.0版（v16），保留小王优化

**问题**：1.3版本的v34复杂算法（候选池加权积累、7张难检牌专项优化、花色总和分析等）成功率反而不如1.0版本（v16滑动窗口）。

**决策**：将识别算法回退到1.0版本的v16框架，同时保留从v28/v29/v30移植的小王相关优化。

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

**修改文件**：`K230/main.py`

---

## 2026-05-17

### B题第二圈停车后声光无法自动停止

**问题**：B题跑完第二圈后，蜂鸣器和 LED 持续响/亮，无法自动关闭。

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

**修改文件**：`stm32/Core/Src/app_line.c`、`stm32/Core/Src/user_main.c`

---

## 2026-05-17

### 从 1.2 创建 1.3 存档

- 从 1.2 完整复制所有源码和配置文件
- 清理缓存：.pio、MDK-ARM/build

---

## 2026-05-17

### 说明书 v2.2 修正（§7.1/§7.2 流程图与代码对齐）

**修改文件**：`竞赛小车工程总说明书.md`

**修正内容：**

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

---

## 2026-05-15（下午）

### 两题停车时均增加声光提示

**修改文件**：`app_line.c`、`app_line.h`、`user_main.c`

**需求**：B题和F题在最终停车时都应发出声光提示（蜂鸣器+LED）。

**修改内容**：

1. **`app_line.c`** — 停车时统一触发声光：
   - B题第二圈停车时：蜂鸣器响 + LED亮，1秒后自动关闭
   - F题一圈停车时：蜂鸣器响 + LED亮，1秒后自动关闭（与B题停车行为一致）
   - B题第一圈声光提示逻辑保持不变

2. **`app_line.c`** — 新增 `App_Line_CheckAlertOff()` 函数：
   - 检查声光提示是否已达到1秒
   - 达到后自动关闭蜂鸣器和LED
   - 避免在 `App_Line_Task()` 之外（状态已切换为FINISHED）无法执行关闭逻辑

3. **`app_line.h`** — 新增 `App_Line_CheckAlertOff()` 声明

4. **`user_main.c`** — 主循环中调用 `App_Line_CheckAlertOff()`：
   - 每次主循环检查声光是否需要关闭
   - 适用于B题第一圈提示、B题第二圈停车、F题停车三种场景

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

### 代码审查修复（2026-05-15 晚）

**修复内容：**

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

### 代码审查 - 发现多个严重 Bug

**审查范围**：STM32 全部源码 + K230/main.py + 所有头文件 + 竞赛说明书

**发现严重 Bug（需立即修复）：**

#### 🔴 Bug 1：B题/F题逻辑完全写反了

**文件**：`stm32/Core/Src/app_line.c` 第 305-324 行

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

**实际后果**：
| 题目 | 预期 | 实际 |
|---|---|---|
| B题 | 一圈声光→再跑一圈→停车 | 直接停车（没有声光） |
| F题 | 一圈停车+K230停止识别 | 声光提示（无停止识别） |

**修复**：将第 305 行和第 313 行中的 `QUESTION_B` ↔ `QUESTION_F` 互换

#### 🔴 Bug 2：F题串口START发送逻辑位置错误

**文件**：`stm32/Core/Src/user_main.c` 第 117-120 行

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

**修复**：将 `BSP_UART_K230_SendStart()` 移到 K2 的启动分支中

#### 🔴 Bug 3：OLED待机页距离计算公式错误

**文件**：`stm32/Core/Src/bsp_oled.c` 第 115 行

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

**修复**：改为 `enc_total / ONE_LAP_COUNT * 3.14159f * WHEEL_DIAMETER_CM`

#### 🔴 Bug 4：编码器达到上限后继续累加

**文件**：`stm32/Core/Src/app_line.c` 第 298-302 行

**问题**：ENC_TOTAL_MAX 截断后下一帧仍继续累加 delta，导致编码器值在上限附近持续波动

**修复**：达到上限后不再累加，或设置标志位

#### 🔴 Bug 5：K230 JOKER_B Boost 条件注释与代码逻辑不符

**文件**：`K230/main.py` 第 636-638 行

**问题**：注释说"差距过大时跳过"，但检查的是 boost 前的差距。应改为检查 boost 后的差距

**修复**：改为 `if boosted_jb > 0 and top1_val - boosted_jb < JOKER_B_MAX_GAP:`

#### 🟡 Bug 6：bsp_uart_k230.h 注释协议与代码不符

**问题**：头文件注释写的是 `$START\n`/`$STOP\n`，实际代码发送的是 `0x01`/`0x02` 单字节

#### 🟡 Bug 7：app_control.c 无用的 (void) 强转

**文件**：`app32/Core/Src/app_control.c` 第 40-43 行

**问题**：`App_Control_SetLineParams()` 函数有一串无意义的 `(void)` 语句

#### 🟡 Bug 8：bsp_gray.c 版本号未更新

**文件**：`stm32/Core/Src/bsp_gray.c` 第 12 行

**问题**：版本 1.0，日期 2026-05-13，其他文件都已更新到 1.1 / 2026-05-15

#### 🟡 Bug 9：app_line.c 注释数字写错

**文件**：`stm32/Core/Src/app_line.c` 第 264 行

**问题**：注释写"150ms~150ms"，应为"150ms~500ms"

---

### 待机页按键2/3功能互换

**修改文件**：`stm32/Core/Src/user_main.c`

**互换内容**：
- K2：待机页由"启动"改为"切换题目（B/F）"
- K3：待机页由"切换题目"改为"启动"

**调整理由**：操作习惯更顺手。

---

### 竞赛小车工程总说明书 v2.1 — 题目细节补充 + 串口功能明确

**更新内容：**

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

**待完成功能（精简后）：**
- 高优先级：ONE_LAP_COUNT 实测标定
- 中优先级：K230与STM32联调、B题第二圈、F题LCD界面优化

### K230 扑克牌识别算法 v1.1 — 最终稳定版

**本次整理**：删除 v8-v34 详细迭代记录，保留最终版本核心说明。

**最终参数配置**：

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

**最终参数配置（续）**：

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

**算法核心特性**：

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

3. **花色总和分析**（v33）：
   - 移除花色补偿，改为计算每种花色的 softmax 置信度总和
   - 同颜色不同花色冲突时（H vs D，S vs C），用花色总和对进行裁决

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

6. **同 rank 过滤**：
   - confirmed_cards 永久排除（整次运行）
   - cooldown_ranks 临时排除（仅冷却期内）

7. **TRACKING 分支降级投票**：
   - Top1 被确认/冷却时自动降级到 Top2/3

**算法版本演进简史**：

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

### K230 代码整理 v1.3 — UI 中文分色 + FPS 恢复

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

**修改文件**：`K230/main.py`

## 2026-05-15（下午）

### 代码整理 v1.1 — 删除冗余注释 + 统一版本号

**问题**：多个源码文件存在大量重复的文件头注释（同一个文件有 2-3 个重复的 `@file` 块），版本号均为 1.0，需要清理。

**`stm32/Core/Src/app_line.c`**：
- 去除重复文件头注释
- 版本更新为 1.1，日期更新为 2026-05-15
- 注释描述精简，保留核心功能说明

**`stm32/Core/Src/bsp_oled.c`**：
- 版本更新为 1.1，日期更新为 2026-05-15
- 注释描述修正

**`stm32/Core/Src/app_control.c`**：
- 版本更新为 1.1，日期更新为 2026-05-15

**`stm32/Core/Src/bsp_uart_k230.c`**：
- 去除重复文件头注释（原有 3 个重复块）
- 版本更新为 1.1，日期更新为 2026-05-15

**`stm32/Core/Src/app_state.c`**：
- 去除重复文件头注释（原有 3 个重复块）
- 版本更新为 1.1，日期更新为 2026-05-15

**`stm32/Core/Src/bsp_motor.c`**：
- 去除重复文件头注释（原有 2 个重复块）
- 版本更新为 1.1，日期更新为 2026-05-15

**`stm32/Core/Src/bsp_encoder.c`**：
- 去除重复文件头注释（原有 2 个重复块）
- 版本更新为 1.1，日期更新为 2026-05-15

**`stm32/Core/Src/bsp_beep.c`**：
- 去除重复文件头注释（原有 2 个重复块）
- 版本更新为 1.1，日期更新为 2026-05-15

**`stm32/Core/Src/bsp_led.c`**：
- 去除重复文件头注释（原有 3 个重复块）
- 版本更新为 1.1，日期更新为 2026-05-15

**`stm32/Core/Src/bsp_gray.c`**：
- 去除重复文件头注释
- 版本更新为 1.1，日期更新为 2026-05-15

**`stm32/Core/Src/bsp_delay.c`**：
- 去除重复文件头注释（原有 2 个重复块）
- 版本更新为 1.1，日期更新为 2026-05-15

**`stm32/Core/Src/bsp_key.c`**：
- 去除重复文件头注释（原有 2 个重复块）
- 版本更新为 1.1，日期更新为 2026-05-15

**`K230/main.py`**：
- 去除内部版本标注混乱
- 版本更新为 1.1，日期更新为 2026-05-15
- 文件头注释精简，保留核心功能说明

## 2026-05-15（凌晨）

### K230 识别算法 v34 — 微调参数减少漏牌

**问题回顾（v33 测试反馈）**：
- 基本差不多了，有部分漏牌和错误
- 换个角度或位置基本都能测准
- 花色裁决 Top1/2 分差调到 0.2 效果很不错

**v34 参数微调（基于用户反馈）**：

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

### K230 识别算法 v33 — 彻底移除花色补偿，改为花色总和裁决

**问题回顾（v32 测试反馈）**：
- 数量准确，颜色准确
- 同颜色不同花色分不清（如红桃 vs 方块、黑桃 vs 梅花）
- 花色补偿会影响原本就正常的识别
- 小王又变成黑桃A

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

### K230 识别算法 v31 — 针对性优化7张难检牌

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

### K230 识别算法 v30 — JOKER_B Boost 防误触发机制

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

### K230 识别算法 v29 — JOKER_B Boost 机制

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

### K230 识别算法 v28 — S_A↔JOKER混淆修正 + 花色补偿优化

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

### K230 识别算法 v27 — 7张难检牌专项优化

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

### K230 识别算法 v26 — 修复"一张牌检测到多张"问题

**v25 Bug 根因分析**：
- COOLDOWN 分支只过滤 `idx ∈ confirmed_cards`，不检查 rank
- 冷却期内同一物理牌的不同花色全部进入候选池 → 某花色达到2票 → 被误确认为新牌

**v26 核心修复**：
1. COOLDOWN 分支增加 rank ∈ cooldown_ranks 过滤
2. TRACKING 分支增加 rank ∈ cooldown_ranks 过滤 + 降级投票

### K230 识别算法 v25 — 难检牌专项优化

**v25 根因分析与核心修复**：
1. TRACKING 分支 Top1 被过滤时直接丢弃 → 改为降级投票
2. COOLDOWN 分支候选池积累不足 → 确保每帧至少一个候选
3. COOLDOWN 每帧检查候选池：达到阈值立即确认

### K230 识别算法 v23 — 每张牌独立 vote_count

**v23 Bug 详解**：
- 共享 vote_window 导致不同花色互抢
- D_5 和 H_3 各 1 票互不相让，H_3 永远无法确认

**v23 核心修复**：
- 每张牌有独立的 `vote_counts[idx]` 计数器
- 每帧只有 Top1 计入对应牌的计数器

### K230 识别算法 v22 — 候选池机制

**v22 Bug 详解**：
- 冷却期内 cls_idx=-1 的帧不加入 vote_window，导致冷却期结束后窗口为空

**v22 核心修复：引入候选池机制**：
- 冷却期内所有有效帧加入 candidate_pool
- 冷却期结束分析候选池，达到阈值则立即确认

## 2026-05-15（凌晨）

### K230 识别算法 v20 — 修复 COOLDOWN 分支 elif 缺少 rank 检查

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

**v20 核心修复**：
- COOLDOWN 分支 elif 增加 rank 检查
- 冷却期内 Top1 是已确认牌时，只有当 rank 不在 cooldown_ranks 中才替换

### K230 识别算法 v19 — 修复确认后窗口未清空

**v18 Bug**：
- 确认一张牌后 vote_window 未清空，已确认牌继续在窗口中占位

**v19 核心修复**：
- 确认后立即清空 vote_window
- 冷却期内也检查 cooldown_ranks

## 2026-05-14（深夜）

### K230 识别算法 v18 — 修复投票计数Bug（核心Bug导致8张牌0确认）

**v17 Bug**：
- `_add_to_window()` 中有去重逻辑，同一张牌第二次出现时被跳过
- `_get_best_in_window()` 统计的是不同牌的种类数，而不是每张牌的出现次数

**v18 核心修复**：
- 移除去重逻辑，同一张牌可以多次加入窗口
- 预热期缩短：30帧→15帧
- 冷却期缩短：20帧→15帧

### K230 识别算法 v17 — 滑动窗口投票 + 宽松冷却

**v16 丢牌分析**：
- H_3 被检测到但因部分帧置信度 0.45-0.57 低于 0.60 阈值

**v17 核心修复**：
- MIN_CONFIDENCE 从 0.60 → 0.45
- 滑动窗口投票：5帧窗口，3帧同牌确认
- 冷却期只排具体牌，不排同 rank

## 2026-05-14（晚）

### K230 识别日志功能

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

## 2026-05-13（晚）

### 代码整理 + 注释规范化 + 版本1.0封装

**文件头注释补全**：为所有C源文件添加标准文件头注释（@file、@brief、功能概述、版本、日期）。

**`app_line.h`**：Kp/Ki/Kd 类型从 `float` 改为 `int16_t`（配合参数扩大10倍存储）

**`app_line.c`**：
- PID 参数扩大10倍存储（B_KP=120/B_KD=50/F_KP=60/F_KD=40）
- 去除重复的 PID 参数赋值代码块

**`bsp_oled.c`**：`Page_Param()` 改用整数运算替代 `%f` 浮点格式化

### 圆形赛道循迹优化（误差平滑 + 积分项）

- **F题启用积分项**：`F_KI` 从 0 改为 3（消除稳态误差）
- **B题 BASE_PWM** 从 1250 调整为 1300

### PID 参数扩大10倍存储（支持±0.1微调）

- PID 参数内部扩大10倍存储（int16_t），OLED 显示时除以 10.0
- K3/K4 每次 ±1，对应实际 PID 值变化 ±0.1

## 2026-05-13（下午）

### OLED 上电初始化延时修复

- 新 OLED 屏幕内部有更长的上电稳定时间
- `OLED_Init()` 开头增加 100ms 延时

### K230 识别算法 v16 — 解决"一张牌检测出多张牌"问题

**v15 根因**：冷却期结束后重置 `confirmed_cards` 和 `confirmed_ranks`，导致同一张牌被重新确认

**v16 核心修复**：
- `confirmed_cards` 和 `confirmed_ranks` 在整次运行中永久生效
- 冷却期结束后不清空，只清空 `vote_window`

### K230 识别算法 v15 — 滑动窗口投票

- 7帧滑动窗口，3帧同牌确认
- 允许模型在窗口中跳1-2帧，减少丢牌

### K230 识别算法 v14 — 彻底重写状态机（连续帧确认）

- 连续5帧确认替代窗口统计
- 打断即重置，从根本上堵住积分游戏漏洞

### K230 识别算法 v13 — 修复一牌多结果 + 防无牌误识别增强

- 新增 `confirmed_ranks` 集合，同 rank 所有牌同时过滤
- BLANK_GAP 提高：0.20 → 0.25

### K230 识别算法 v12 — 确认后立即排除已确认牌

- 新增 `confirmed_cards` 集合（永久排除）
- 每帧先过滤已确认牌，Top1 被确认则自动替换为 Top2

### K230 识别算法 v10 — 解决 H_7/D_7 互抢丢牌 + 花色置信度裁决

- 去掉 Top-N 辅助计数，只计最终 Top1
- 新增 `_resolve_frame()` 花色置信度裁决

### K230 识别算法 v9 — 参数优化（针对前两张牌丢牌率高）

- 预热期：50帧→30帧，窗口：20帧→15帧
- 确认阈值：8次→6次，冷却期：20帧→15帧

### K230 识别算法全面重写 v8 — 稳定性确认 + 冷却期状态机

- `StabilityStateMachine` 类替代 `SlidingWindowManager`
- 状态流转：IDLE → CONFIRMING → COOLDOWN
- 冷却期机制彻底解决"一张牌读出多种"问题

## 2026-05-12（下午）

### OLED待机页显示行驶距离和用时

- 待机页第二行：行驶距离（cm）
- 待机页第三行：行驶用时（精确到0.01秒）
- 快照变量记录停车时刻的编码器值

### K230 数据收集脚本更新

- 6种类别（C_7, D_3, D_K, D_Q, JOKER_B, JOKER_R）
- 每种 200 张（1 批次），共 1200 张

### K230 识别器 v6/v7 — BLANK 防误识别 + 开机预热

- BLANK 分差门槛：Top1 必须比 BLANK 高至少 0.15
- 开机预热：前15帧识别结果不入滑动窗口

### K230 LCD 屏幕驱动修复

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

## 2026-05-12（上午）

### K230 数据收集脚本重写（扑克牌识别训练数据）

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

### K230 LCD 屏幕不显示问题修复

## 2026-05-11（晚）

### F题串口通信 + K230扑克牌识别展示

- STM32 → K230：`$START\n` / `$STOP\n`
- K230 串口协议改为纯字节：0x01(START)/0x02(STOP)
- 白屏展示：白色背景，中文花色名称逐行打印

### 题目逻辑修正 + 代码清理

- B题：一圈后声光提示，再跑完一圈停车（共两圈）
- F题：一圈后直接停车

## 2026-05-11

### OLED页面简化：删除调试页，自动跳转待机页

### 题目枚举重构：B1→B（基础题），B2→F（发挥题）

### K230 main.py 全面迁移至 PipeLine 框架

- 适配 CanMV K230 v1.6
- 通道0显示，通道2 AI推理

## 2026-05-10

### 代码全面检查与修复

- `gpio.c`：修正 PB4/PB5 引脚注释
- `09_1数据收集.py`：修复按键去抖逻辑错误
- `app_line.c`：为 `s_enc_total` 添加上限保护

### B2题声光提示修正 + LED亮灭逻辑修正

- 声光提示1秒后自动关闭
- LED 亮灭逻辑修正

### 基础题B1/B2双题支持及一圈/两圈计数

- 新增 `QuestionType_t` 枚举
- B1：一圈停车，B2：两圈后声光提示再跑完两圈停车

### 巡线一圈自动停车功能

- `ONE_LAP_COUNT` 宏定义一圈目标编码器值
- 达到目标后自动停车 + 切换 FINISHED 状态

### 巡线方向修正（左右PWM分配反了）

- 交换左右轮 PWM 公式

## 2026-05-09

### 第五阶段：开环低速循迹

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

## 2026-05-08

- 检查并整理 STM32 工程结构
- 修正右轮电机接线顺序
- 新增编码器测试功能
- 扩展串口调试命令支持

## 2026-05-09

### 灰度传感器驱动开发

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

### 最终接线对应

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

### 2026-05-20 | main_new2.py VOTING 窗口判断 bug 修复

**问题**：`VOTING` 状态下窗口结束条件用 `voting_frames_collected >= WINDOW_SIZE`，但该计数器只在低置信度帧（cls_idx < 0 或无 valid candidates）时不递增，导致低置信度帧出现时窗口无限拉长。

**修复**：将窗口结束条件改为 `round_total_frames >= WINDOW_SIZE`（每帧必递增），并修正 `_tick_finalize` 调用以避免 `cls_idx < 0` 时引用未定义变量 `valid`。

### 2026-05-20 | main_new2.py DISCARDING 帧数超时修复

**问题**：`DISCARDING` 状态下 `cls_idx < 0` 或无 valid candidates 时直接 return，`round_total_frames` 未递增，帧配额被浪费，导致无限等待。

**修复**：入口统一递增 `round_total_frames`，设置总超时上限 `DISCARD_FRAMES + WINDOW_SIZE = 9` 帧，超时后强制进入 VOTING（重置投票状态后继续，不丢弃本轮）。

### 2026-05-21 | app_line.c F题参数统一

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

### 2026-05-21 | main_new2.py v22 回顾一致性检查（S_10 vs C_8 覆写）

**目的**：解决 S_10 和 C_8 容易互相误识别的问题。当投票确认 S_10 后，对本轮投票历史做回顾检查，三条件全满足则覆写为 C_8。

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
