sivarconf/2026-/2.0/stm32/Core/Inc/app_control.h

#ifndef __APP_CONTROL_H
#define __APP_CONTROL_H

#include "stdint.h"

void App_Control_Init(void);
void App_Control_Task(void);

/* 循迹参数控制 */
void App_Control_SetLineParams(int16_t base_pwm, int16_t Kp, int16_t Ki, int16_t Kd);

#endif
