sivarconf/2026-/3.0/stm32/Core/Inc/app_control.h

/**
 * @file    app_control.h
 * @brief   电机控制调度模块接口
 *
 * 版本：3.0
 * 日期：2026-05-21
 */

#ifndef __APP_CONTROL_H
#define __APP_CONTROL_H

#include "stdint.h"

void App_Control_Init(void);
void App_Control_Task(void);

#endif
