sivarconf/2026-/2.0/stm32/Core/Src/OLED.c

#include "stm32f1xx_hal.h"
#include "i2c.h"
#include "OLED.h"
#include <string.h>
#include <math.h>
#include <stdio.h>
#include <stdarg.h>

/**
  * 数据存储格式：
  * 纵向8点，高位在下，先从左到右，再从上到下
  * 每一个Bit对应一个像素点
  *
  *      B0 B0                  B0 B0
  *      B1 B1                  B1 B1
  *      B2 B2                  B2 B2
  *      B3 B3  ------------->  B3 B3 --
  *      B4 B4                  B4 B4  |
  *      B5 B5                  B5 B5  |
  *      B6 B6                  B6 B6  |
  *      B7 B7                  B7 B7  |
  *                                    |
  *  -----------------------------------
  *  |
  *  |   B0 B0                  B0 B0
  *  |   B1 B1                  B1 B1
  *  |   B2 B2                  B2 B2
  *  --> B3 B3  ------------->  B3 B3
  *      B4 B4                  B4 B4
  *      B5 B5                  B5 B5
  *      B6 B6                  B6 B6
  *      B7 B7                  B7 B7
  *
  * 坐标轴定义：
  * 左上角为(0, 0)点
  * 横向向右为X轴，取值范围：0~127
  * 纵向向下为Y轴，取值范围：0~63
  */


/*全局变量*********************/

/**
  * OLED显存数组
  * 所有的显示函数，都只是对此显存数组进行读写
  * 随后调用OLED_Update函数或OLED_UpdateArea函数
  * 才会将显存数组的数据发送到OLED硬件，进行显示
  */
uint8_t OLED_DisplayBuf[8][128];

/*********************全局变量*/


/*硬件I2C配置*********************/

/*OLED I2C地址（OLED 7位地址为0x3C，HAL_I2C_Master_Transmit要求传入8位写地址，即0x3C<<1=0x78）*/
#define OLED_I2C_ADDR        (0x3C << 1)

/*I2C传输缓冲区（最大128字节数据+1字节控制字节）*/
static uint8_t s_i2c_buf[129];

/*调试开关（设为1启用串口调试输出）*/
#define OLED_DEBUG    1

/*********************硬件I2C配置*/


/*通信协议*********************/

/**
  * 函    数：OLED写命令
  * 参    数：Command 要写入的命令值，范围：0x00~0xFF
  * 返 回 值：无
  */
void OLED_WriteCommand(uint8_t Command)
{
	uint8_t buf[2] = {0x00, Command};
	HAL_I2C_Master_Transmit(&hi2c1, OLED_I2C_ADDR, buf, 2, HAL_MAX_DELAY);
}

/**
  * 函    数：OLED写数据
  * 参    数：Data 要写入数据的起始地址
  * 参    数：Count 要写入数据的数量
  * 返 回 值：无
  */
void OLED_WriteData(uint8_t *Data, uint8_t Count)
{
	if (Count > 128) return;

	s_i2c_buf[0] = 0x40;
	for (uint8_t i = 0; i < Count; i++)
	{
		s_i2c_buf[i + 1] = Data[i];
	}
	HAL_I2C_Master_Transmit(&hi2c1, OLED_I2C_ADDR, s_i2c_buf, Count + 1, HAL_MAX_DELAY);
}

/*********************通信协议*/


/*硬件配置*********************/

/**
  * 函    数：OLED初始化
  * 参    数：无
  * 返 回 值：无
  * 说    明：使用前，需要调用此初始化函数
  *           依赖硬件I2C1已在main.c中通过MX_I2C1_Init()初始化
  */
void OLED_Init(void)
{
	HAL_Delay(100);  // 新OLED上电后需等待内部稳定，低功耗模块上电响应较慢

	/*写入一系列的命令，对OLED进行初始化配置*/
	OLED_WriteCommand(0xAE);	//设置显示开启/关闭，0xAE关闭，0xAF开启

	OLED_WriteCommand(0xD5);	//设置显示时钟分频比/振荡器频率
	OLED_WriteCommand(0x80);	//0x00~0xFF

	OLED_WriteCommand(0xA8);	//设置多路复用率
	OLED_WriteCommand(0x3F);	//0x0E~0x3F

	OLED_WriteCommand(0xD3);	//设置显示偏移
	OLED_WriteCommand(0x00);	//0x00~0x7F

	OLED_WriteCommand(0x40);	//设置显示开始行，0x40~0x7F

	OLED_WriteCommand(0xA1);	//设置左右方向，0xA1正常，0xA0左右反置

	OLED_WriteCommand(0xC8);	//设置上下方向，0xC8正常，0xC0上下反置

	OLED_WriteCommand(0xDA);	//设置COM引脚硬件配置
	OLED_WriteCommand(0x12);

	OLED_WriteCommand(0x81);	//设置对比度
	OLED_WriteCommand(0xCF);	//0x00~0xFF

	OLED_WriteCommand(0xD9);	//设置预充电周期
	OLED_WriteCommand(0xF1);

	OLED_WriteCommand(0xDB);	//设置VCOMH取消选择级别
	OLED_WriteCommand(0x30);

	OLED_WriteCommand(0xA4);	//设置整个显示打开/关闭

	OLED_WriteCommand(0xA6);	//设置正常/反色显示，0xA6正常，0xA7反色

	OLED_WriteCommand(0x8D);	//设置充电泵
	OLED_WriteCommand(0x14);

	OLED_WriteCommand(0xAF);	//开启显示

	OLED_Clear();				//清空显存数组
	OLED_Update();				//更新显示，清屏，防止初始化后未显示内容时花屏
}

/**
  * 函    数：OLED设置显示光标位置
  * 参    数：Page 指定光标所在的页，范围：0~7
  * 参    数：X 指定光标所在的X轴坐标，范围：0~127
  * 返 回 值：无
  * 说    明：OLED默认的Y轴，只能8个Bit为一组写入，即1页等于8个Y轴坐标
  */
void OLED_SetCursor(uint8_t Page, uint8_t X)
{
	/*通过指令设置页地址和列地址*/
	OLED_WriteCommand(0xB0 | Page);					//设置页位置
	OLED_WriteCommand(0x10 | ((X & 0xF0) >> 4));	//设置X位置高4位
	OLED_WriteCommand(0x00 | (X & 0x0F));			//设置X位置低4位
}

/*********************硬件配置*/


/*工具函数*********************/

/*工具函数仅供内部部分函数使用*/

/**
  * 函    数：次方函数
  * 参    数：X 底数
  * 参    数：Y 指数
  * 返 回 值：等于X的Y次方
  */
uint32_t OLED_Pow(uint32_t X, uint32_t Y)
{
	uint32_t Result = 1;
	while (Y --)
	{
		Result *= X;
	}
	return Result;
}

/**
  * 函    数：判断指定点是否在指定多边形内部
  * 参    数：nvert 多边形的顶点数
  * 参    数：vertx verty 包含多边形顶点的x和y坐标的数组
  * 参    数：testx testy 测试点的X和y坐标
  * 返 回 值：指定点是否在指定多边形内部，1：在内部，0：不在内部
  */
uint8_t OLED_pnpoly(uint8_t nvert, int16_t *vertx, int16_t *verty, int16_t testx, int16_t testy)
{
	int16_t i, j, c = 0;

	for (i = 0, j = nvert - 1; i < nvert; j = i++)
	{
		if (((verty[i] > testy) != (verty[j] > testy)) &&
			(testx < (vertx[j] - vertx[i]) * (testy - verty[i]) / (verty[j] - verty[i]) + vertx[i]))
		{
			c = !c;
		}
	}
	return c;
}

/**
  * 函    数：判断指定点是否在指定角度内部
  * 参    数：X Y 指定点的坐标
  * 参    数：StartAngle EndAngle 起始角度和终止角度，范围：-180~180
  *           水平向右为0度，水平向左为180度或-180度，下方为正数，上方为负数，顺时针旋转
  * 返 回 值：指定点是否在指定角度内部，1：在内部，0：不在内部
  */
uint8_t OLED_IsInAngle(int16_t X, int16_t Y, int16_t StartAngle, int16_t EndAngle)
{
	int16_t PointAngle;
	PointAngle = atan2(Y, X) / 3.14 * 180;
	if (StartAngle < EndAngle)
	{
		if (PointAngle >= StartAngle && PointAngle <= EndAngle)
		{
			return 1;
		}
	}
	else
	{
		if (PointAngle >= StartAngle || PointAngle <= EndAngle)
		{
			return 1;
		}
	}
	return 0;
}

/*********************工具函数*/


/*功能函数*********************/

/**
  * 函    数：将OLED显存数组更新到OLED屏幕
  * 参    数：无
  * 返 回 值：无
  * 说    明：所有的显示函数，都只是对OLED显存数组进行读写
  *           随后调用OLED_Update函数或OLED_UpdateArea函数
  *           才会将显存数组的数据发送到OLED硬件，进行显示
  *           故调用显示函数后，要想真正地呈现在屏幕上，还需调用更新函数
  */
void OLED_Update(void)
{
	uint8_t j;
	for (j = 0; j < 8; j ++)
	{
		OLED_SetCursor(j, 0);
		OLED_WriteData(OLED_DisplayBuf[j], 128);
	}
}

/**
  * 函    数：将OLED显存数组部分更新到OLED屏幕
  * 参    数：X 指定区域左上角的横坐标，范围：-32768~32767，屏幕区域：0~127
  * 参    数：Y 指定区域左上角的纵坐标，范围：-32768~32767，屏幕区域：0~63
  * 参    数：Width 指定区域的宽度，范围：0~128
  * 参    数：Height 指定区域的高度，范围：0~64
  * 返 回 值：无
  */
void OLED_UpdateArea(int16_t X, int16_t Y, uint8_t Width, uint8_t Height)
{
	int16_t j;
	int16_t Page, Page1;

	Page = Y / 8;
	Page1 = (Y + Height - 1) / 8 + 1;
	if (Y < 0)
	{
		Page -= 1;
		Page1 -= 1;
	}

	for (j = Page; j < Page1; j ++)
	{
		if (X >= 0 && X <= 127 && j >= 0 && j <= 7)
		{
			OLED_SetCursor(j, X);
			OLED_WriteData(&OLED_DisplayBuf[j][X], Width);
		}
	}
}

/**
  * 函    数：将OLED显存数组全部清零
  * 参    数：无
  * 返 回 值：无
  */
void OLED_Clear(void)
{
	uint8_t i, j;
	for (j = 0; j < 8; j ++)
	{
		for (i = 0; i < 128; i ++)
		{
			OLED_DisplayBuf[j][i] = 0x00;
		}
	}
}

/**
  * 函    数：将OLED显存数组部分清零
  * 参    数：X 指定区域左上角的横坐标，范围：-32768~32767，屏幕区域：0~127
  * 参    数：Y 指定区域左上角的纵坐标，范围：-32768~32767，屏幕区域：0~63
  * 参    数：Width 指定区域的宽度，范围：0~128
  * 参    数：Height 指定区域的高度，范围：0~64
  * 返 回 值：无
  */
void OLED_ClearArea(int16_t X, int16_t Y, uint8_t Width, uint8_t Height)
{
	int16_t i, j;

	for (j = Y; j < Y + Height; j ++)
	{
		for (i = X; i < X + Width; i ++)
		{
			if (i >= 0 && i <= 127 && j >=0 && j <= 63)
			{
				OLED_DisplayBuf[j / 8][i] &= ~(0x01 << (j % 8));
			}
		}
	}
}

/**
  * 函    数：将OLED显存数组全部取反
  * 参    数：无
  * 返 回 值：无
  */
void OLED_Reverse(void)
{
	uint8_t i, j;
	for (j = 0; j < 8; j ++)
	{
		for (i = 0; i < 128; i ++)
		{
			OLED_DisplayBuf[j][i] ^= 0xFF;
		}
	}
}

/**
  * 函    数：将OLED显存数组部分取反
  * 参    数：X 指定区域左上角的横坐标，范围：-32768~32767，屏幕区域：0~127
  * 参    数：Y 指定区域左上角的纵坐标，范围：-32768~32767，屏幕区域：0~63
  * 参    数：Width 指定区域的宽度，范围：0~128
  * 参    数：Height 指定区域的高度，范围：0~64
  * 返 回 值：无
  */
void OLED_ReverseArea(int16_t X, int16_t Y, uint8_t Width, uint8_t Height)
{
	int16_t i, j;

	for (j = Y; j < Y + Height; j ++)
	{
		for (i = X; i < X + Width; i ++)
		{
			if (i >= 0 && i <= 127 && j >=0 && j <= 63)
			{
				OLED_DisplayBuf[j / 8][i] ^= 0x01 << (j % 8);
			}
		}
	}
}

/**
  * 函    数：OLED显示一个字符
  * 参    数：X 指定字符左上角的横坐标，范围：-32768~32767，屏幕区域：0~127
  * 参    数：Y 指定字符左上角的纵坐标，范围：-32768~32767，屏幕区域：0~63
  * 参    数：Char 指定要显示的字符，范围：ASCII码可见字符
  * 参    数：FontSize 指定字体大小
  *           范围：OLED_8X16		宽8像素，高16像素
  *                 OLED_6X8		宽6像素，高8像素
  * 返 回 值：无
  */
void OLED_ShowChar(int16_t X, int16_t Y, char Char, uint8_t FontSize)
{
	if (FontSize == OLED_8X16)
	{
		OLED_ShowImage(X, Y, 8, 16, OLED_F8x16[Char - ' ']);
	}
	else if(FontSize == OLED_6X8)
	{
		OLED_ShowImage(X, Y, 6, 8, OLED_F6x8[Char - ' ']);
	}
}

/**
  * 函    数：OLED显示字符串（支持ASCII码和中文混合写入）
  * 参    数：X 指定字符串左上角的横坐标，范围：-32768~32767，屏幕区域：0~127
  * 参    数：Y 指定字符串左上角的纵坐标，范围：-32768~32767，屏幕区域：0~63
  * 参    数：String 指定要显示的字符串，范围：ASCII码可见字符或中文字符组成的字符串
  * 参    数：FontSize 指定字体大小
  *           范围：OLED_8X16		宽8像素，高16像素
  *                 OLED_6X8		宽6像素，高8像素
  * 返 回 值：无
  */
void OLED_ShowString(int16_t X, int16_t Y, char *String, uint8_t FontSize)
{
	uint16_t i = 0;
	char SingleChar[5];
	uint8_t CharLength = 0;
	uint16_t XOffset = 0;
	uint16_t pIndex;

	while (String[i] != '\0')
	{

#ifdef OLED_CHARSET_UTF8
		if ((String[i] & 0x80) == 0x00)
		{
			CharLength = 1;
			SingleChar[0] = String[i ++];
			SingleChar[1] = '\0';
		}
		else if ((String[i] & 0xE0) == 0xC0)
		{
			CharLength = 2;
			SingleChar[0] = String[i ++];
			if (String[i] == '\0') {break;}
			SingleChar[1] = String[i ++];
			SingleChar[2] = '\0';
		}
		else if ((String[i] & 0xF0) == 0xE0)
		{
			CharLength = 3;
			SingleChar[0] = String[i ++];
			if (String[i] == '\0') {break;}
			SingleChar[1] = String[i ++];
			if (String[i] == '\0') {break;}
			SingleChar[2] = String[i ++];
			SingleChar[3] = '\0';
		}
		else if ((String[i] & 0xF8) == 0xF0)
		{
			CharLength = 4;
			SingleChar[0] = String[i ++];
			if (String[i] == '\0') {break;}
			SingleChar[1] = String[i ++];
			if (String[i] == '\0') {break;}
			SingleChar[2] = String[i ++];
			if (String[i] == '\0') {break;}
			SingleChar[3] = String[i ++];
			SingleChar[4] = '\0';
		}
		else
		{
			i ++;
			continue;
		}
#endif

#ifdef OLED_CHARSET_GB2312
		if ((String[i] & 0x80) == 0x00)
		{
			CharLength = 1;
			SingleChar[0] = String[i ++];
			SingleChar[1] = '\0';
		}
		else
		{
			CharLength = 2;
			SingleChar[0] = String[i ++];
			if (String[i] == '\0') {break;}
			SingleChar[1] = String[i ++];
			SingleChar[2] = '\0';
		}
#endif

		if (CharLength == 1)
		{
			OLED_ShowChar(X + XOffset, Y, SingleChar[0], FontSize);
			XOffset += FontSize;
		}
		else
		{
			for (pIndex = 0; strcmp(OLED_CF16x16[pIndex].Index, "") != 0; pIndex ++)
			{
				if (strcmp(OLED_CF16x16[pIndex].Index, SingleChar) == 0)
				{
					break;
				}
			}
			if (FontSize == OLED_8X16)
			{
				OLED_ShowImage(X + XOffset, Y, 16, 16, OLED_CF16x16[pIndex].Data);
				XOffset += 16;
			}
			else if (FontSize == OLED_6X8)
			{
				OLED_ShowChar(X + XOffset, Y, '?', OLED_6X8);
				XOffset += OLED_6X8;
			}
		}
	}
}

/**
  * 函    数：OLED显示数字（十进制，正整数）
  * 参    数：X 指定数字左上角的横坐标，范围：-32768~32767，屏幕区域：0~127
  * 参    数：Y 指定数字左上角的纵坐标，范围：-32768~32767，屏幕区域：0~63
  * 参    数：Number 指定要显示的数字，范围：0~4294967295
  * 参    数：Length 指定数字的长度，范围：0~10
  * 参    数：FontSize 指定字体大小
  *           范围：OLED_8X16		宽8像素，高16像素
  *                 OLED_6X8		宽6像素，高8像素
  * 返 回 值：无
  */
void OLED_ShowNum(int16_t X, int16_t Y, uint32_t Number, uint8_t Length, uint8_t FontSize)
{
	uint8_t i;
	for (i = 0; i < Length; i++)
	{
		OLED_ShowChar(X + i * FontSize, Y, Number / OLED_Pow(10, Length - i - 1) % 10 + '0', FontSize);
	}
}

/**
  * 函    数：OLED显示有符号数字（十进制，整数）
  * 参    数：X 指定数字左上角的横坐标，范围：-32768~32767，屏幕区域：0~127
  * 参    数：Y 指定数字左上角的纵坐标，范围：-32768~32767，屏幕区域：0~63
  * 参    数：Number 指定要显示的数字，范围：-2147483648~2147483647
  * 参    数：Length 指定数字的长度，范围：0~10
  * 参    数：FontSize 指定字体大小
  *           范围：OLED_8X16		宽8像素，高16像素
  *                 OLED_6X8		宽6像素，高8像素
  * 返 回 值：无
  */
void OLED_ShowSignedNum(int16_t X, int16_t Y, int32_t Number, uint8_t Length, uint8_t FontSize)
{
	uint8_t i;
	uint32_t Number1;

	if (Number >= 0)
	{
		OLED_ShowChar(X, Y, '+', FontSize);
		Number1 = Number;
	}
	else
	{
		OLED_ShowChar(X, Y, '-', FontSize);
		Number1 = -Number;
	}

	for (i = 0; i < Length; i++)
	{
		OLED_ShowChar(X + (i + 1) * FontSize, Y, Number1 / OLED_Pow(10, Length - i - 1) % 10 + '0', FontSize);
	}
}

/**
  * 函    数：OLED显示十六进制数字（十六进制，正整数）
  * 参    数：X 指定数字左上角的横坐标，范围：-32768~32767，屏幕区域：0~127
  * 参    数：Y 指定数字左上角的纵坐标，范围：-32768~32767，屏幕区域：0~63
  * 参    数：Number 指定要显示的数字，范围：0x00000000~0xFFFFFFFF
  * 参    数：Length 指定数字的长度，范围：0~8
  * 参    数：FontSize 指定字体大小
  *           范围：OLED_8X16		宽8像素，高16像素
  *                 OLED_6X8		宽6像素，高8像素
  * 返 回 值：无
  */
void OLED_ShowHexNum(int16_t X, int16_t Y, uint32_t Number, uint8_t Length, uint8_t FontSize)
{
	uint8_t i, SingleNumber;
	for (i = 0; i < Length; i++)
	{
		SingleNumber = Number / OLED_Pow(16, Length - i - 1) % 16;

		if (SingleNumber < 10)
		{
			OLED_ShowChar(X + i * FontSize, Y, SingleNumber + '0', FontSize);
		}
		else
		{
			OLED_ShowChar(X + i * FontSize, Y, SingleNumber - 10 + 'A', FontSize);
		}
	}
}

/**
  * 函    数：OLED显示二进制数字（二进制，正整数）
  * 参    数：X 指定数字左上角的横坐标，范围：-32768~32767，屏幕区域：0~127
  * 参    数：Y 指定数字左上角的纵坐标，范围：-32768~32767，屏幕区域：0~63
  * 参    数：Number 指定要显示的数字，范围：0x00000000~0xFFFFFFFF
  * 参    数：Length 指定数字的长度，范围：0~16
  * 参    数：FontSize 指定字体大小
  *           范围：OLED_8X16		宽8像素，高16像素
  *                 OLED_6X8		宽6像素，高8像素
  * 返 回 值：无
  */
void OLED_ShowBinNum(int16_t X, int16_t Y, uint32_t Number, uint8_t Length, uint8_t FontSize)
{
	uint8_t i;
	for (i = 0; i < Length; i++)
	{
		OLED_ShowChar(X + i * FontSize, Y, Number / OLED_Pow(2, Length - i - 1) % 2 + '0', FontSize);
	}
}

/**
  * 函    数：OLED显示浮点数字（十进制，小数）
  * 参    数：X 指定数字左上角的横坐标，范围：-32768~32767，屏幕区域：0~127
  * 参    数：Y 指定数字左上角的纵坐标，范围：-32768~32767，屏幕区域：0~63
  * 参    数：Number 指定要显示的数字，范围：-4294967295.0~4294967295.0
  * 参    数：IntLength 指定数字的整数位长度，范围：0~10
  * 参    数：FraLength 指定数字的小数位长度，范围：0~9，小数进行四舍五入显示
  * 参    数：FontSize 指定字体大小
  *           范围：OLED_8X16		宽8像素，高16像素
  *                 OLED_6X8		宽6像素，高8像素
  * 返 回 值：无
  */
void OLED_ShowFloatNum(int16_t X, int16_t Y, double Number, uint8_t IntLength, uint8_t FraLength, uint8_t FontSize)
{
	uint32_t PowNum, IntNum, FraNum;

	if (Number >= 0)
	{
		OLED_ShowChar(X, Y, '+', FontSize);
	}
	else
	{
		OLED_ShowChar(X, Y, '-', FontSize);
		Number = -Number;
	}

	IntNum = Number;
	Number -= IntNum;
	PowNum = OLED_Pow(10, FraLength);
	FraNum = round(Number * PowNum);
	IntNum += FraNum / PowNum;

	OLED_ShowNum(X + FontSize, Y, IntNum, IntLength, FontSize);
	OLED_ShowChar(X + (IntLength + 1) * FontSize, Y, '.', FontSize);
	OLED_ShowNum(X + (IntLength + 2) * FontSize, Y, FraNum, FraLength, FontSize);
}

/**
  * 函    数：OLED显示图像
  * 参    数：X 指定图像左上角的横坐标，范围：-32768~32767，屏幕区域：0~127
  * 参    数：Y 指定图像左上角的纵坐标，范围：-32768~32767，屏幕区域：0~63
  * 参    数：Width 指定图像的宽度，范围：0~128
  * 参    数：Height 指定图像的高度，范围：0~64
  * 参    数：Image 指定要显示的图像
  * 返 回 值：无
  */
void OLED_ShowImage(int16_t X, int16_t Y, uint8_t Width, uint8_t Height, const uint8_t *Image)
{
	uint8_t i = 0, j = 0;
	int16_t Page, Shift;

	OLED_ClearArea(X, Y, Width, Height);

	for (j = 0; j < (Height - 1) / 8 + 1; j ++)
	{
		for (i = 0; i < Width; i ++)
		{
			if (X + i >= 0 && X + i <= 127)
			{
				Page = Y / 8;
				Shift = Y % 8;
				if (Y < 0)
				{
					Page -= 1;
					Shift += 8;
				}

				if (Page + j >= 0 && Page + j <= 7)
				{
					OLED_DisplayBuf[Page + j][X + i] |= Image[j * Width + i] << (Shift);
				}

				if (Page + j + 1 >= 0 && Page + j + 1 <= 7)
				{
					OLED_DisplayBuf[Page + j + 1][X + i] |= Image[j * Width + i] >> (8 - Shift);
				}
			}
		}
	}
}

/**
  * 函    数：OLED使用printf函数打印格式化字符串
  * 参    数：X 指定格式化字符串左上角的横坐标，范围：-32768~32767，屏幕区域：0~127
  * 参    数：Y 指定格式化字符串左上角的纵坐标，范围：-32768~32767，屏幕区域：0~63
  * 参    数：FontSize 指定字体大小
  *           范围：OLED_8X16		宽8像素，高16像素
  *                 OLED_6X8		宽6像素，高8像素
  * 参    数：format 指定要显示的格式化字符串
  * 参    数：... 格式化字符串参数列表
  * 返 回 值：无
  */
void OLED_Printf(int16_t X, int16_t Y, uint8_t FontSize, char *format, ...)
{
	char String[256];
	va_list arg;
	va_start(arg, format);
	vsprintf(String, format, arg);
	va_end(arg);
	OLED_ShowString(X, Y, String, FontSize);
}

/**
  * 函    数：OLED在指定位置画一个点
  * 参    数：X 指定点的横坐标，范围：-32768~32767，屏幕区域：0~127
  * 参    数：Y 指定点的纵坐标，范围：-32768~32767，屏幕区域：0~63
  * 返 回 值：无
  */
void OLED_DrawPoint(int16_t X, int16_t Y)
{
	if (X >= 0 && X <= 127 && Y >=0 && Y <= 63)
	{
		OLED_DisplayBuf[Y / 8][X] |= 0x01 << (Y % 8);
	}
}

/**
  * 函    数：OLED获取指定位置点的值
  * 参    数：X 指定点的横坐标，范围：-32768~32767，屏幕区域：0~127
  * 参    数：Y 指定点的纵坐标，范围：-32768~32767，屏幕区域：0~63
  * 返 回 值：指定位置点是否处于点亮状态，1：点亮，0：熄灭
  */
uint8_t OLED_GetPoint(int16_t X, int16_t Y)
{
	if (X >= 0 && X <= 127 && Y >=0 && Y <= 63)
	{
		if (OLED_DisplayBuf[Y / 8][X] & 0x01 << (Y % 8))
		{
			return 1;
		}
	}

	return 0;
}

/**
  * 函    数：OLED画线
  * 参    数：X0 指定一个端点的横坐标，范围：-32768~32767，屏幕区域：0~127
  * 参    数：Y0 指定一个端点的纵坐标，范围：-32768~32767，屏幕区域：0~63
  * 参    数：X1 指定另一个端点的横坐标，范围：-32768~32767，屏幕区域：0~127
  * 参    数：Y1 指定另一个端点的纵坐标，范围：-32768~32767，屏幕区域：0~63
  * 返 回 值：无
  */
void OLED_DrawLine(int16_t X0, int16_t Y0, int16_t X1, int16_t Y1)
{
	int16_t x, y, dx, dy, d, incrE, incrNE, temp;
	int16_t x0 = X0, y0 = Y0, x1 = X1, y1 = Y1;
	uint8_t yflag = 0, xyflag = 0;

	if (y0 == y1)
	{
		if (x0 > x1) {temp = x0; x0 = x1; x1 = temp;}

		for (x = x0; x <= x1; x ++)
		{
			OLED_DrawPoint(x, y0);
		}
	}
	else if (x0 == x1)
	{
		if (y0 > y1) {temp = y0; y0 = y1; y1 = temp;}

		for (y = y0; y <= y1; y ++)
		{
			OLED_DrawPoint(x0, y);
		}
	}
	else
	{
		if (x0 > x1)
		{
			temp = x0; x0 = x1; x1 = temp;
			temp = y0; y0 = y1; y1 = temp;
		}

		if (y0 > y1)
		{
			y0 = -y0;
			y1 = -y1;
			yflag = 1;
		}

		if (y1 - y0 > x1 - x0)
		{
			temp = x0; x0 = y0; y0 = temp;
			temp = x1; x1 = y1; y1 = temp;
			xyflag = 1;
		}

		dx = x1 - x0;
		dy = y1 - y0;
		incrE = 2 * dy;
		incrNE = 2 * (dy - dx);
		d = 2 * dy - dx;
		x = x0;
		y = y0;

		if (yflag && xyflag){OLED_DrawPoint(y, -x);}
		else if (yflag)		{OLED_DrawPoint(x, -y);}
		else if (xyflag)	{OLED_DrawPoint(y, x);}
		else				{OLED_DrawPoint(x, y);}

		while (x < x1)
		{
			x ++;
			if (d < 0)
			{
				d += incrE;
			}
			else
			{
				y ++;
				d += incrNE;
			}

			if (yflag && xyflag){OLED_DrawPoint(y, -x);}
			else if (yflag)		{OLED_DrawPoint(x, -y);}
			else if (xyflag)	{OLED_DrawPoint(y, x);}
			else				{OLED_DrawPoint(x, y);}
		}
	}
}

/**
  * 函    数：OLED矩形
  * 参    数：X 指定矩形左上角的横坐标，范围：-32768~32767，屏幕区域：0~127
  * 参    数：Y 指定矩形左上角的纵坐标，范围：-32768~32767，屏幕区域：0~63
  * 参    数：Width 指定矩形的宽度，范围：0~128
  * 参    数：Height 指定矩形的高度，范围：0~64
  * 参    数：IsFilled 指定矩形是否填充
  *           范围：OLED_UNFILLED		不填充
  *                 OLED_FILLED			填充
  * 返 回 值：无
  */
void OLED_DrawRectangle(int16_t X, int16_t Y, uint8_t Width, uint8_t Height, uint8_t IsFilled)
{
	int16_t i, j;
	if (!IsFilled)
	{
		for (i = X; i < X + Width; i ++)
		{
			OLED_DrawPoint(i, Y);
			OLED_DrawPoint(i, Y + Height - 1);
		}
		for (i = Y; i < Y + Height; i ++)
		{
			OLED_DrawPoint(X, i);
			OLED_DrawPoint(X + Width - 1, i);
		}
	}
	else
	{
		for (i = X; i < X + Width; i ++)
		{
			for (j = Y; j < Y + Height; j ++)
			{
				OLED_DrawPoint(i, j);
			}
		}
	}
}

/**
  * 函    数：OLED三角形
  * 参    数：X0 指定第一个端点的横坐标，范围：-32768~32767，屏幕区域：0~127
  * 参    数：Y0 指定第一个端点的纵坐标，范围：-32768~32767，屏幕区域：0~63
  * 参    数：X1 指定第二个端点的横坐标，范围：-32768~32767，屏幕区域：0~127
  * 参    数：Y1 指定第二个端点的纵坐标，范围：-32768~32767，屏幕区域：0~63
  * 参    数：X2 指定第三个端点的横坐标，范围：-32768~32767，屏幕区域：0~127
  * 参    数：Y2 指定第三个端点的纵坐标，范围：-32768~32767，屏幕区域：0~63
  * 参    数：IsFilled 指定三角形是否填充
  *           范围：OLED_UNFILLED		不填充
  *                 OLED_FILLED			填充
  * 返 回 值：无
  */
void OLED_DrawTriangle(int16_t X0, int16_t Y0, int16_t X1, int16_t Y1, int16_t X2, int16_t Y2, uint8_t IsFilled)
{
	int16_t minx = X0, miny = Y0, maxx = X0, maxy = Y0;
	int16_t i, j;
	int16_t vx[] = {X0, X1, X2};
	int16_t vy[] = {Y0, Y1, Y2};

	if (!IsFilled)
	{
		OLED_DrawLine(X0, Y0, X1, Y1);
		OLED_DrawLine(X0, Y0, X2, Y2);
		OLED_DrawLine(X1, Y1, X2, Y2);
	}
	else
	{
		if (X1 < minx) {minx = X1;}
		if (X2 < minx) {minx = X2;}
		if (Y1 < miny) {miny = Y1;}
		if (Y2 < miny) {miny = Y2;}

		if (X1 > maxx) {maxx = X1;}
		if (X2 > maxx) {maxx = X2;}
		if (Y1 > maxy) {maxy = Y1;}
		if (Y2 > maxy) {maxy = Y2;}

		for (i = minx; i <= maxx; i ++)
		{
			for (j = miny; j <= maxy; j ++)
			{
				if (OLED_pnpoly(3, vx, vy, i, j)) {OLED_DrawPoint(i, j);}
			}
		}
	}
}

/**
  * 函    数：OLED画圆
  * 参    数：X 指定圆的圆心横坐标，范围：-32768~32767，屏幕区域：0~127
  * 参    数：Y 指定圆的圆心纵坐标，范围：-32768~32767，屏幕区域：0~63
  * 参    数：Radius 指定圆的半径，范围：0~255
  * 参    数：IsFilled 指定圆是否填充
  *           范围：OLED_UNFILLED		不填充
  *                 OLED_FILLED			填充
  * 返 回 值：无
  */
void OLED_DrawCircle(int16_t X, int16_t Y, uint8_t Radius, uint8_t IsFilled)
{
	int16_t x, y, d, j;

	d = 1 - Radius;
	x = 0;
	y = Radius;

	OLED_DrawPoint(X + x, Y + y);
	OLED_DrawPoint(X - x, Y - y);
	OLED_DrawPoint(X + y, Y + x);
	OLED_DrawPoint(X - y, Y - x);

	if (IsFilled)
	{
		for (j = -y; j < y; j ++)
		{
			OLED_DrawPoint(X, Y + j);
		}
	}

	while (x < y)
	{
		x ++;
		if (d < 0)
		{
			d += 2 * x + 1;
		}
		else
		{
			y --;
			d += 2 * (x - y) + 1;
		}

		OLED_DrawPoint(X + x, Y + y);
		OLED_DrawPoint(X + y, Y + x);
		OLED_DrawPoint(X - x, Y - y);
		OLED_DrawPoint(X - y, Y - x);
		OLED_DrawPoint(X + x, Y - y);
		OLED_DrawPoint(X + y, Y - x);
		OLED_DrawPoint(X - x, Y + y);
		OLED_DrawPoint(X - y, Y + x);

		if (IsFilled)
		{
			for (j = -y; j < y; j ++)
			{
				OLED_DrawPoint(X + x, Y + j);
				OLED_DrawPoint(X - x, Y + j);
			}

			for (j = -x; j < x; j ++)
			{
				OLED_DrawPoint(X - y, Y + j);
				OLED_DrawPoint(X + y, Y + j);
			}
		}
	}
}

/**
  * 函    数：OLED画椭圆
  * 参    数：X 指定椭圆的圆心横坐标，范围：-32768~32767，屏幕区域：0~127
  * 参    数：Y 指定椭圆的圆心纵坐标，范围：-32768~32767，屏幕区域：0~63
  * 参    数：A 指定椭圆的横向半轴长度，范围：0~255
  * 参    数：B 指定椭圆的纵向半轴长度，范围：0~255
  * 参    数：IsFilled 指定椭圆是否填充
  *           范围：OLED_UNFILLED		不填充
  *                 OLED_FILLED			填充
  * 返 回 值：无
  */
void OLED_DrawEllipse(int16_t X, int16_t Y, uint8_t A, uint8_t B, uint8_t IsFilled)
{
	int16_t x, y, j;
	int16_t a = A, b = B;
	float d1, d2;

	x = 0;
	y = b;
	d1 = b * b + a * a * (-b + 0.5);

	if (IsFilled)
	{
		for (j = -y; j < y; j ++)
		{
			OLED_DrawPoint(X, Y + j);
			OLED_DrawPoint(X, Y + j);
		}
	}

	OLED_DrawPoint(X + x, Y + y);
	OLED_DrawPoint(X - x, Y - y);
	OLED_DrawPoint(X - x, Y + y);
	OLED_DrawPoint(X + x, Y - y);

	while (b * b * (x + 1) < a * a * (y - 0.5))
	{
		if (d1 <= 0)
		{
			d1 += b * b * (2 * x + 3);
		}
		else
		{
			d1 += b * b * (2 * x + 3) + a * a * (-2 * y + 2);
			y --;
		}
		x ++;

		if (IsFilled)
		{
			for (j = -y; j < y; j ++)
			{
				OLED_DrawPoint(X + x, Y + j);
				OLED_DrawPoint(X - x, Y + j);
			}
		}

		OLED_DrawPoint(X + x, Y + y);
		OLED_DrawPoint(X - x, Y - y);
		OLED_DrawPoint(X - x, Y + y);
		OLED_DrawPoint(X + x, Y - y);
	}

	d2 = b * b * (x + 0.5) * (x + 0.5) + a * a * (y - 1) * (y - 1) - a * a * b * b;

	while (y > 0)
	{
		if (d2 <= 0)
		{
			d2 += b * b * (2 * x + 2) + a * a * (-2 * y + 3);
			x ++;
		}
		else
		{
			d2 += a * a * (-2 * y + 3);
		}
		y --;

		if (IsFilled)
		{
			for (j = -y; j < y; j ++)
			{
				OLED_DrawPoint(X + x, Y + j);
				OLED_DrawPoint(X - x, Y + j);
			}
		}

		OLED_DrawPoint(X + x, Y + y);
		OLED_DrawPoint(X - x, Y - y);
		OLED_DrawPoint(X - x, Y + y);
		OLED_DrawPoint(X + x, Y - y);
	}
}

/**
  * 函    数：OLED画圆弧
  * 参    数：X 指定圆弧的圆心横坐标，范围：-32768~32767，屏幕区域：0~127
  * 参    数：Y 指定圆弧的圆心纵坐标，范围：-32768~32767，屏幕区域：0~63
  * 参    数：Radius 指定圆弧的半径，范围：0~255
  * 参    数：StartAngle 指定圆弧的起始角度，范围：-180~180
  *           水平向右为0度，水平向左为180度或-180度，下方为正数，上方为负数，顺时针旋转
  * 参    数：EndAngle 指定圆弧的终止角度，范围：-180~180
  * 参    数：IsFilled 指定圆弧是否填充，填充后为扇形
  *           范围：OLED_UNFILLED		不填充
  *                 OLED_FILLED			填充
  * 返 回 值：无
  */
void OLED_DrawArc(int16_t X, int16_t Y, uint8_t Radius, int16_t StartAngle, int16_t EndAngle, uint8_t IsFilled)
{
	int16_t x, y, d, j;

	d = 1 - Radius;
	x = 0;
	y = Radius;

	if (OLED_IsInAngle(x, y, StartAngle, EndAngle))	{OLED_DrawPoint(X + x, Y + y);}
	if (OLED_IsInAngle(-x, -y, StartAngle, EndAngle)) {OLED_DrawPoint(X - x, Y - y);}
	if (OLED_IsInAngle(y, x, StartAngle, EndAngle)) {OLED_DrawPoint(X + y, Y + x);}
	if (OLED_IsInAngle(-y, -x, StartAngle, EndAngle)) {OLED_DrawPoint(X - y, Y - x);}

	if (IsFilled)
	{
		for (j = -y; j < y; j ++)
		{
			if (OLED_IsInAngle(0, j, StartAngle, EndAngle)) {OLED_DrawPoint(X, Y + j);}
		}
	}

	while (x < y)
	{
		x ++;
		if (d < 0)
		{
			d += 2 * x + 1;
		}
		else
		{
			y --;
			d += 2 * (x - y) + 1;
		}

		if (OLED_IsInAngle(x, y, StartAngle, EndAngle)) {OLED_DrawPoint(X + x, Y + y);}
		if (OLED_IsInAngle(y, x, StartAngle, EndAngle)) {OLED_DrawPoint(X + y, Y + x);}
		if (OLED_IsInAngle(-x, -y, StartAngle, EndAngle)) {OLED_DrawPoint(X - x, Y - y);}
		if (OLED_IsInAngle(-y, -x, StartAngle, EndAngle)) {OLED_DrawPoint(X - y, Y - x);}
		if (OLED_IsInAngle(x, -y, StartAngle, EndAngle)) {OLED_DrawPoint(X + x, Y - y);}
		if (OLED_IsInAngle(y, -x, StartAngle, EndAngle)) {OLED_DrawPoint(X + y, Y - x);}
		if (OLED_IsInAngle(-x, y, StartAngle, EndAngle)) {OLED_DrawPoint(X - x, Y + y);}
		if (OLED_IsInAngle(-y, x, StartAngle, EndAngle)) {OLED_DrawPoint(X - y, Y + x);}

		if (IsFilled)
		{
			for (j = -y; j < y; j ++)
			{
				if (OLED_IsInAngle(x, j, StartAngle, EndAngle)) {OLED_DrawPoint(X + x, Y + j);}
				if (OLED_IsInAngle(-x, j, StartAngle, EndAngle)) {OLED_DrawPoint(X - x, Y + j);}
			}

			for (j = -x; j < x; j ++)
			{
				if (OLED_IsInAngle(-y, j, StartAngle, EndAngle)) {OLED_DrawPoint(X - y, Y + j);}
				if (OLED_IsInAngle(y, j, StartAngle, EndAngle)) {OLED_DrawPoint(X + y, Y + j);}
			}
		}
	}
}

/*********************功能函数*/
