sivarconf/2026-/2.0/stm32/Core/Inc/app_line.h

#ifndef __APP_LINE_H
#define __APP_LINE_H

#include <stdint.h>
#include "app_state.h"

/* ============================ 循迹参数 ============================ */

typedef struct {
    int16_t base_pwm;
    int16_t Kp;   /* 内部扩大10倍存储，显示时除10 */
    int16_t Ki;
    int16_t Kd;
} LineParams_t;

typedef enum {
    LINE_TUNE_BASE_PWM = 0,
    LINE_TUNE_KP,
    LINE_TUNE_KI,
    LINE_TUNE_KD
} LineTuneParam_t;

/* ============================ 丢线策略 ============================ */

typedef enum {
    LINE_OK = 0,
    LINE_LOST_SHORT,
    LINE_LOST_MED,
    LINE_LOST_LONG,
    LINE_CARD_COVER
} LineStatus_t;

/* ============================ 初始化 ============================ */

void App_Line_Init(void);

/* ============================ 核心任务 ============================ */

/* 读取灰度并执行PD控制
 * 仅在 APP_STATE_RUNNING 时调用
 * 周期：LINE_TASK_PERIOD_MS (5ms) */
void App_Line_Task(void);

/* ============================ 参数读写 ============================ */

void App_Line_SetParams(int16_t base_pwm, int16_t Kp, int16_t Ki, int16_t Kd);
void App_Line_GetParams(LineParams_t *params);
void App_Line_GetQuestionParams(QuestionType_t q, LineParams_t *params);
void App_Line_SetQuestionParams(QuestionType_t q, const LineParams_t *params);
LineTuneParam_t App_Line_GetTuneParam(void);
void App_Line_NextTuneParam(void);
void App_Line_AdjustQuestionTuneParam(QuestionType_t q, int16_t delta);
uint8_t App_Line_IsStableMode(void);
void App_Line_ToggleStableMode(void);
int16_t App_Line_GetError(void);
int32_t App_Line_GetEncTotal(void);
LineStatus_t App_Line_GetStatus(void);
void App_Line_RecordSnapshot(void);
void App_Line_RecordFinish(void);
void App_Line_CheckAlertOff(void);
uint32_t App_Line_GetRunningTimeS(void);
float App_Line_GetRunningTime100ms(void);
uint32_t App_Line_GetRunningTimeMs(void);
float App_Line_GetSnapshotDist(void);

/* ============================ 调试输出 ============================ */

void App_Line_PrintDebug(void);

#endif
